foostan/mkbd/developers_guide/developrs_guide_jp.md

# 開発者向けガイド(JP)
## はじめに
これは Meishi Keyboard を開発する方向けのガイドです。
チュートリアル形式で `mkbd/pcb` のような "名刺型" のキーボードを作る過程を説明します。

## PCB 設計
### 新規プロジェクトの開始

KiCad を起動し、「ファイル > 新規 > プロジェクト」から新規プロジェクトの作成します。

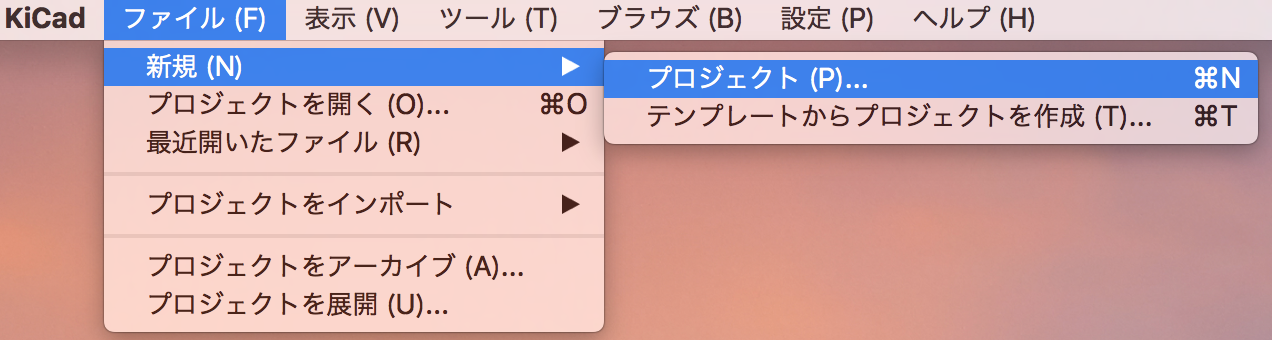
[picture p1: developers_guide/images/new_project/new_project.png]
new_project


プロジェクト名を決めて [Save] します。 

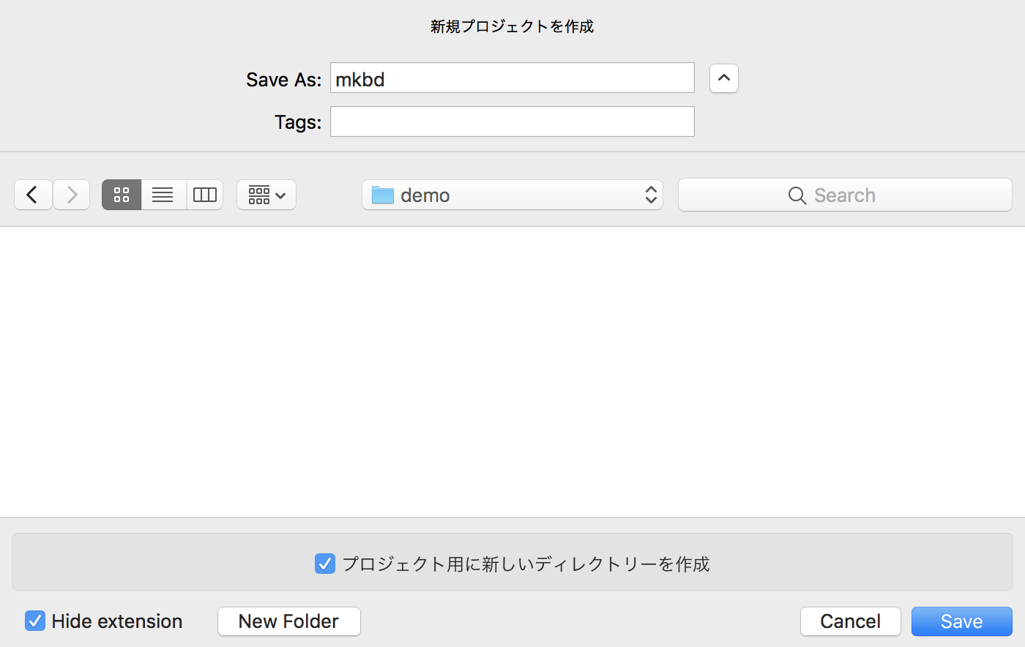
[picture p2: developers_guide/images/new_project/save_new_project.png]
save_new_project


KiCad プロジェクトのメインメニュー画面が表示されます。
各種ツールはこの画面から起動するので時間があればどのようなものがあるか確認しておきましょう。
今は時間がないので先に進みます。

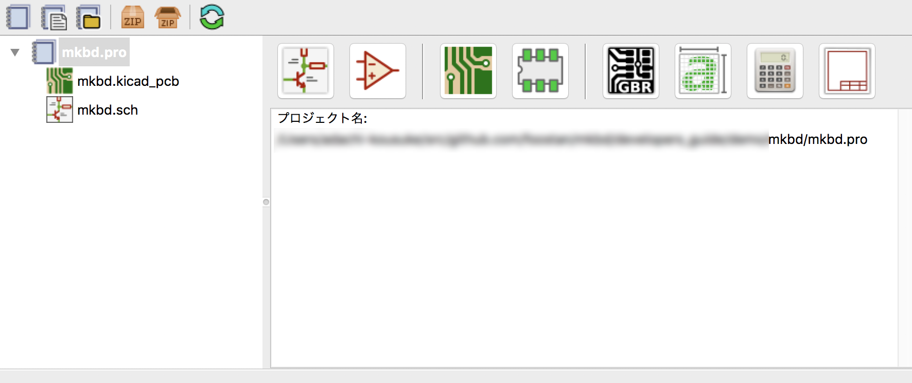
[picture p3: developers_guide/images/new_project/global_menu.png]
global_menu


### 回路設計

まずはキーボードの回路を設計していきます。
グローバルメニューから、「回路図レイアウト エディター」を開きます。

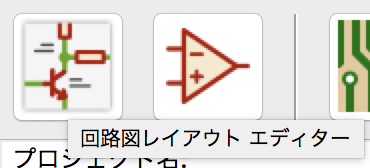
[picture p4: developers_guide/images/eeschema/open_eeschema.png]
open_eeschema


これが回路図レイアウトエディター(以降 Eeschema)の作業画面です。

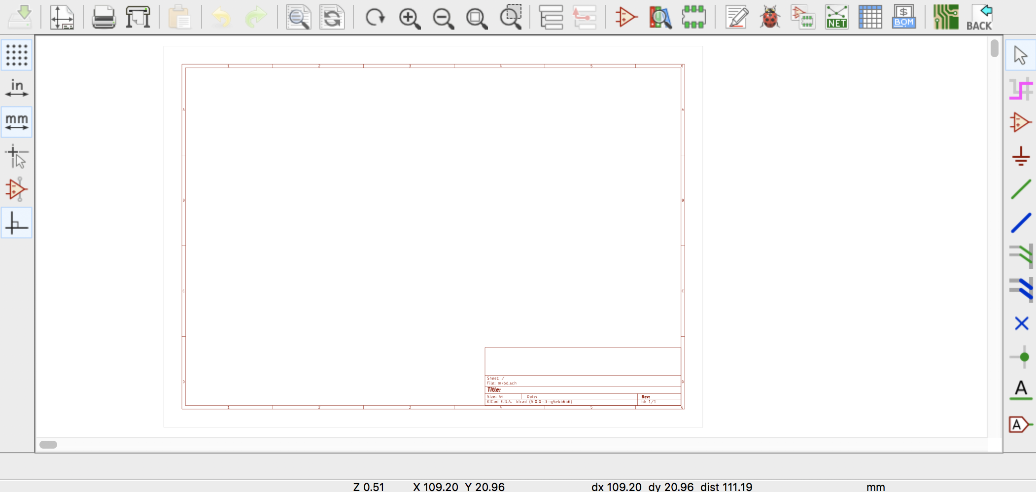
[picture p5: developers_guide/images/eeschema/start_eeschema.png]
start_eeschema


今は設計に必要な最低限な説明しかしないのでもし体系的に学びたい場合は「ヘルプ > KiCad ことはじめ」を開いて見てください。
KiCad の使い方を細かく学ぶことができるのでおすすめです。

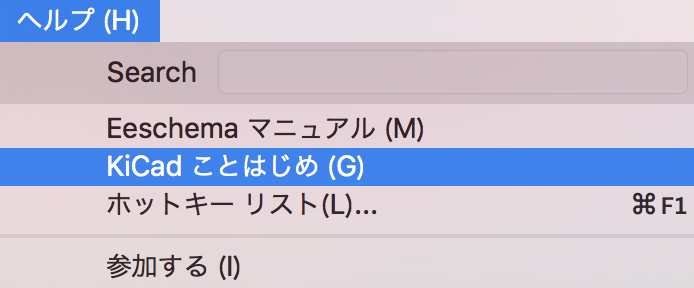
[picture p6: developers_guide/images/eeschema/kotohajime.png]
kotohajime


設計を始める前に、まずはキーボードに必要なパーツ(ライブラリ)を手に入れます。
以下のように必要なライブラリを GitHub 上から取得します。

```
$ git clone https://github.com/foostan/kbd
```

もしくは https://github.com/foostan/kbd にアクセスしてダウンロードしてください。

次に取得したライブラリを「設定 > シンボル ライブラリーを管理...」 から読み込みます。

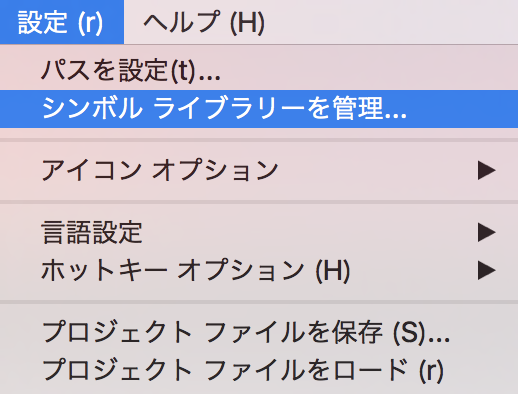
[picture p7: developers_guide/images/eeschema/manage_lib.png]
manage_lib


[ライブラリーを参照...] から `kbd/library/kbd.lib` を [Open] します。

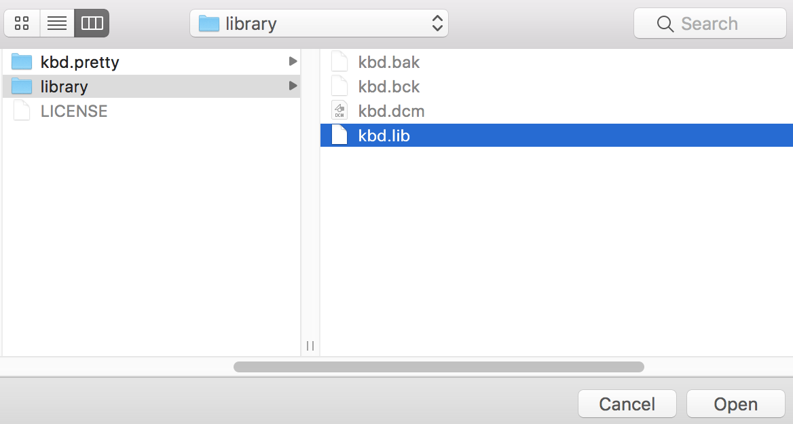
[picture p8: developers_guide/images/eeschema/open_lib.png]
open_lib


これで回路を設計する準備が整いました。
Eeschema の作業画面でショートカット `a` を押してシンボルの選択ウインドウを開きます。
検索フォームに「promicro_r」と入力して、「ProMicro_r」を選択し [OK] します。

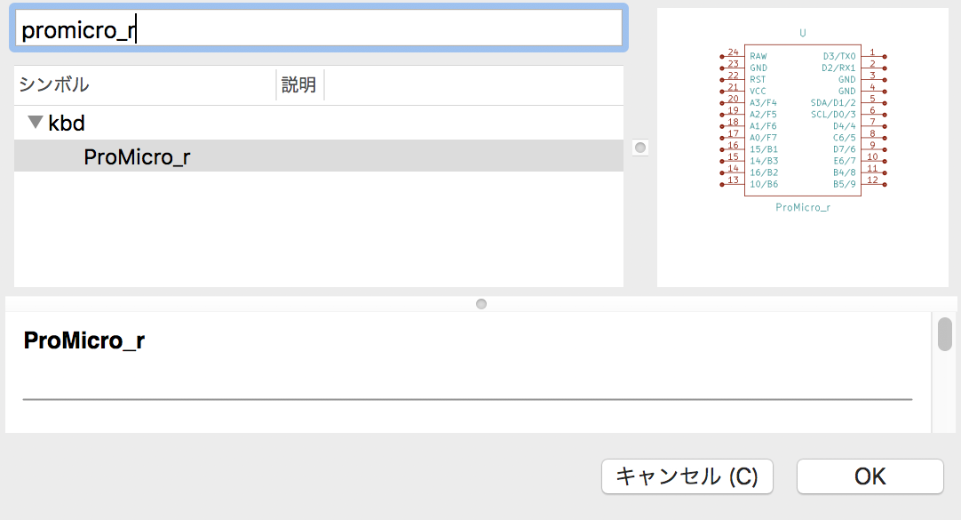
[picture p9: developers_guide/images/eeschema/add_promicro_r.png]
add_promicro_r


適当な配置します。

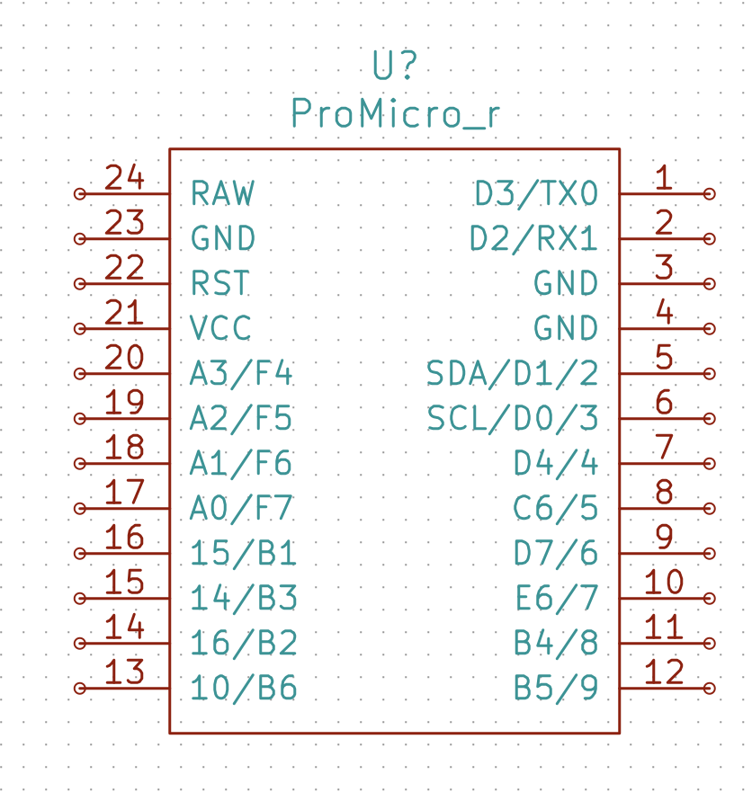
[picture p10: developers_guide/images/eeschema/set_promicro_r.png]
set_promicro_r


もし手元に実物の「ProMicro」があれば見比べてみましょう。
部品が実装されていない面の向きになっていることが確認できると思います。
回路設計においては実物と形や向きを揃える必要はありませんが、初学者にとっては実物が想像できたほうが理解が捗るので、
もし外部のライブラリーを使う場合は見てわかりやすいものを選ぶのがいいかもしれしれません。

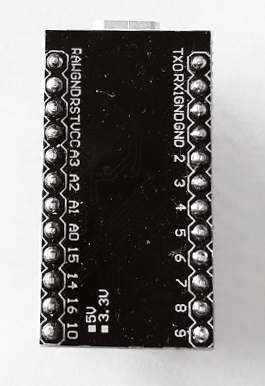
[picture p11: developers_guide/images/eeschema/promicro.png]
promicro


次にキースイッチを配置していきます。
今回は6つのキーが付いたキーボードを設計してみます。

Eeschema の作業画面でショートカット `a` を押してシンボルの選択ウインドウを開きます。

検索フォームに「sw_push」と入力して、「SW_PUSH」を選択し [OK] します。

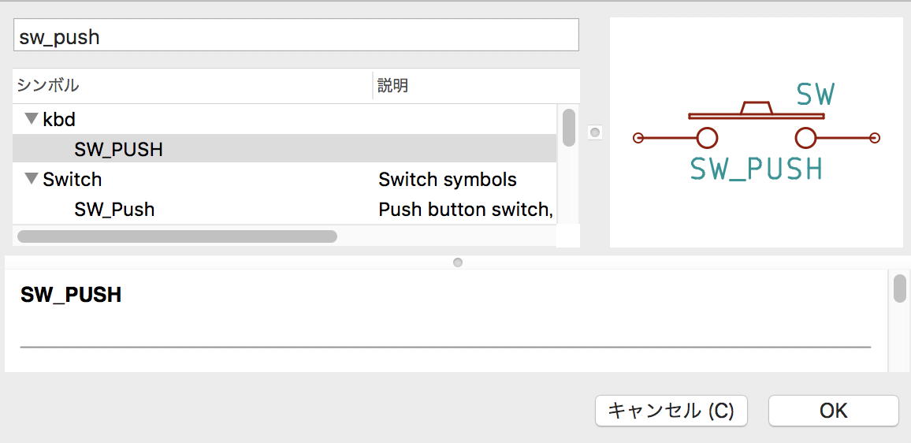
[picture p12: developers_guide/images/eeschema/add_sw_push.png]
add_sw_push


わかりやすいように整列させて並べます。
シンボルを移動させる場合は、シンボルにカーソルを合わせてショートカット `m` を押して移動させたい場所に動かします。 

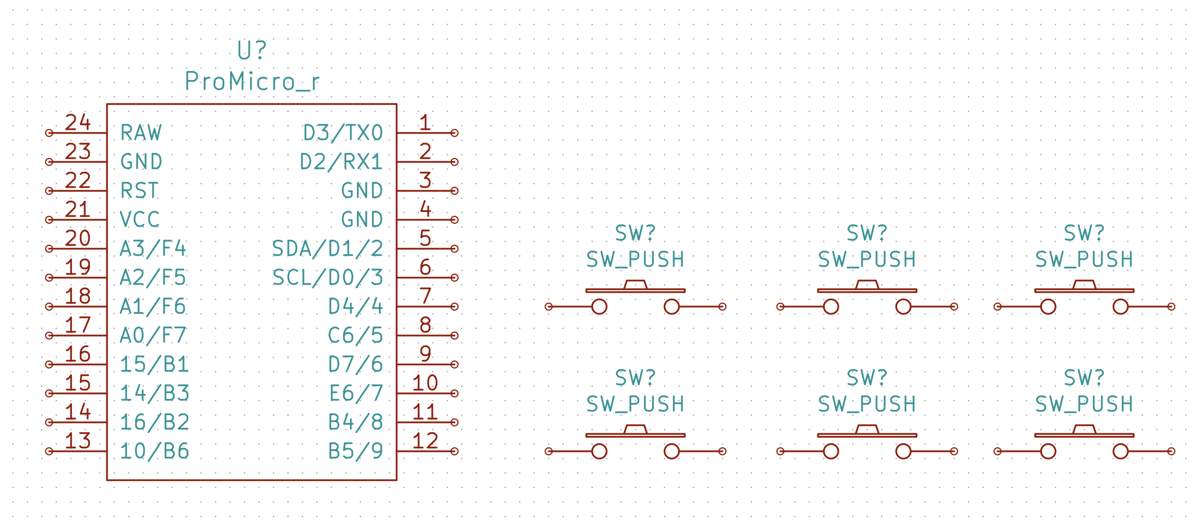
[picture p13: developers_guide/images/eeschema/set_sw_push.png]
set_sw_push


次にキースイッチをProMicroにつなげていきます。
ショートカット `w` を押して下記画像を参考にしながらつなげましょう。
もしもっとスッキリと配線させたい場合は「ラベル」を使ったやり方もあるので「KiCad ことはじめ」等でやり方を探ってみてください。

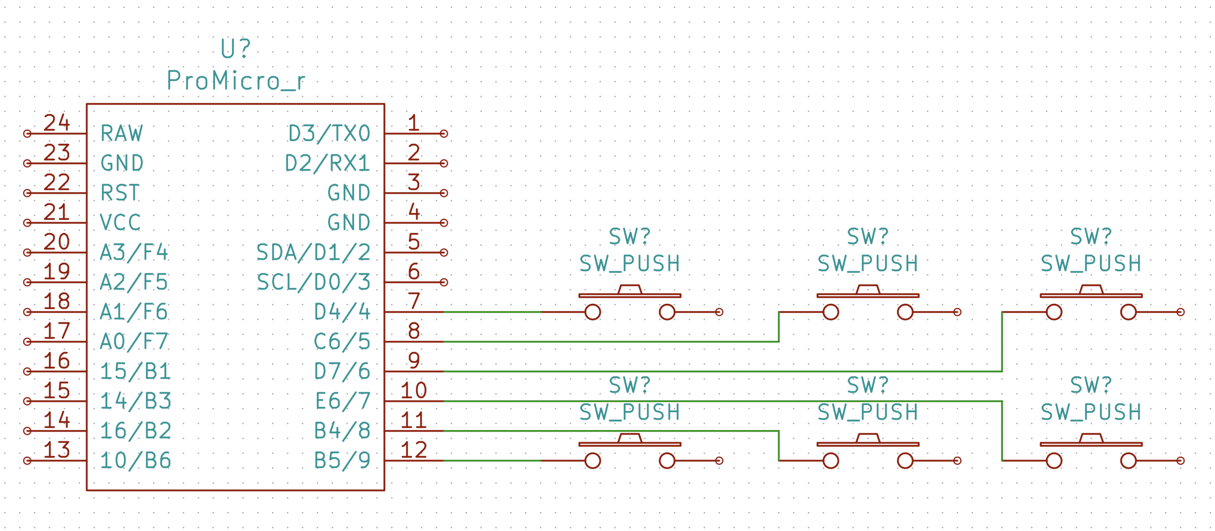
[picture p14: developers_guide/images/eeschema/wiring_sw_push.png]
wiring_sw_push


次にキースイッチのもう片方の足を GND に落とします。
Eeschema の作業画面でショートカット `a` を押してシンボルの選択ウインドウを開きます。
検索フォームに「gnd」と入力して、「GND」を選択し [OK] します。

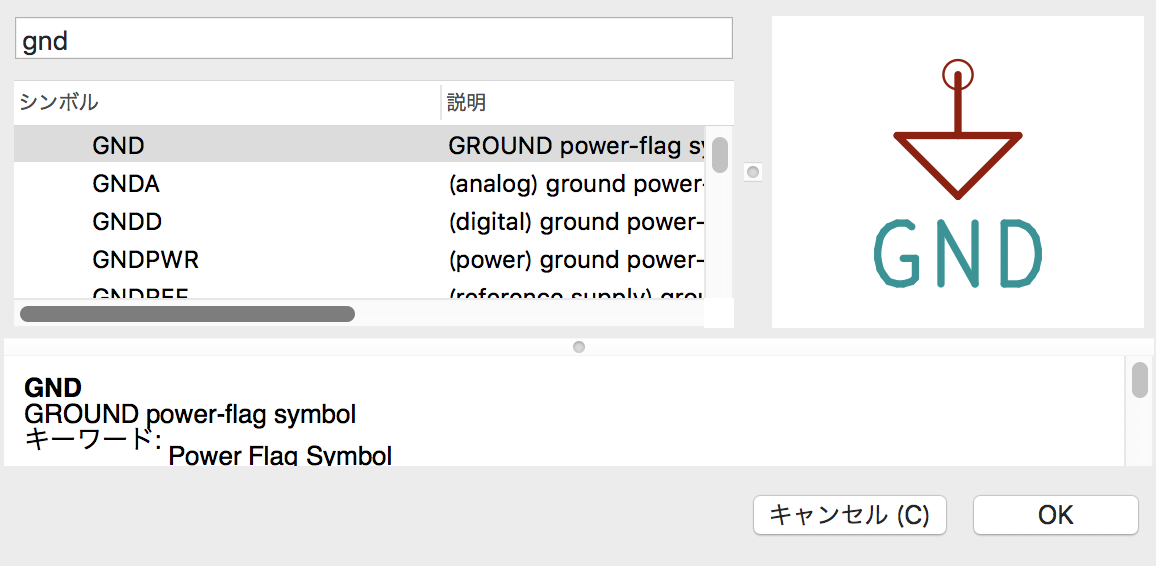
[picture p15: developers_guide/images/eeschema/add_gnd.png]
add_gnd


下記画像を参考に GND を付けていきます。
見栄えが気になった方は、ショートカット `g` や ショートカット `r` などで調整してみてください(各ショートカットの挙動は実際に確認してみてください)。

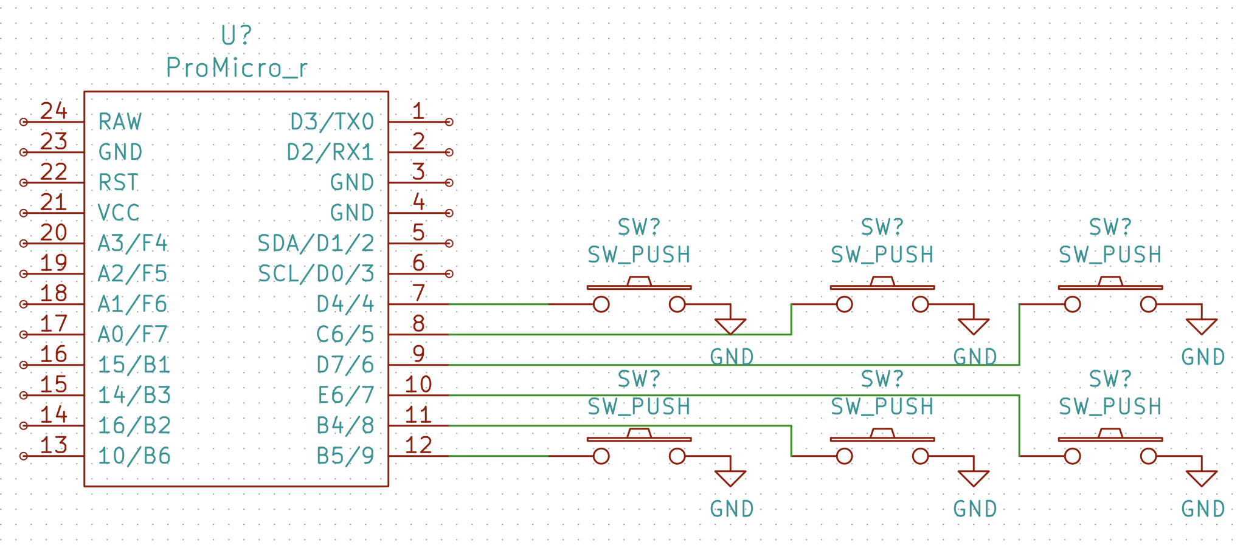
[picture p16: developers_guide/images/eeschema/set_gnd.png]
set_gnd


次にリセットスイッチを付けていきます。
Eeschema の作業画面でショートカット `a` を押してシンボルの選択ウインドウを開きます。
検索フォームに「sw_push」と入力して、「SW_Push」を選択し [OK] します。
キースイッチと同じものでも問題ありませんが、見た目が違うものの方がわかりやすいのであえて変えました。

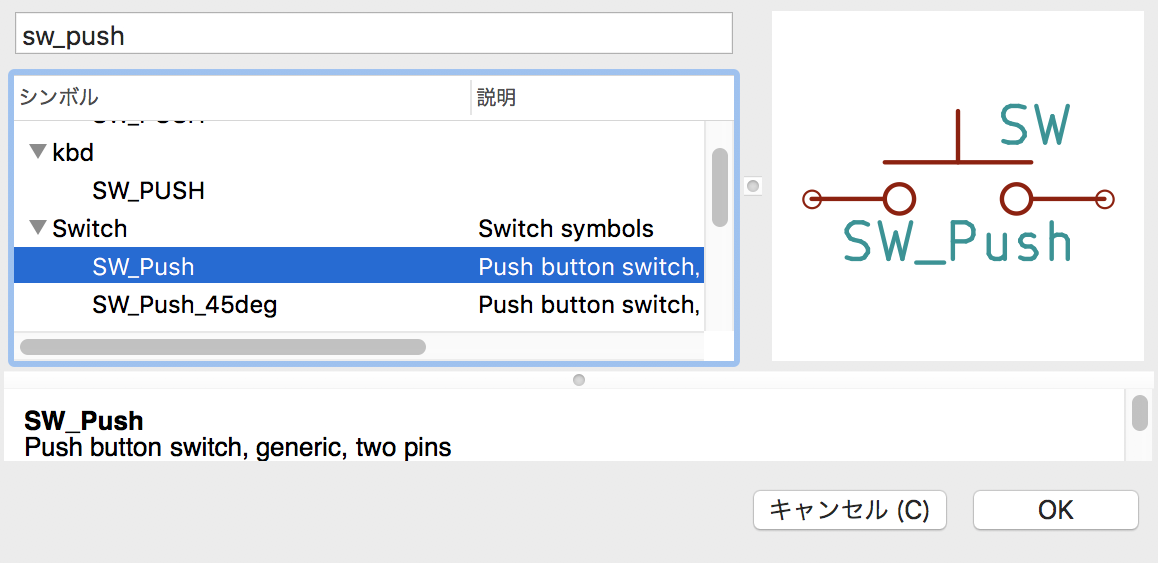
[picture p17: developers_guide/images/eeschema/add_sw_push_reset.png]
add_sw_push_reset


キースイッチと同じ方法で配線および GND を付けます。

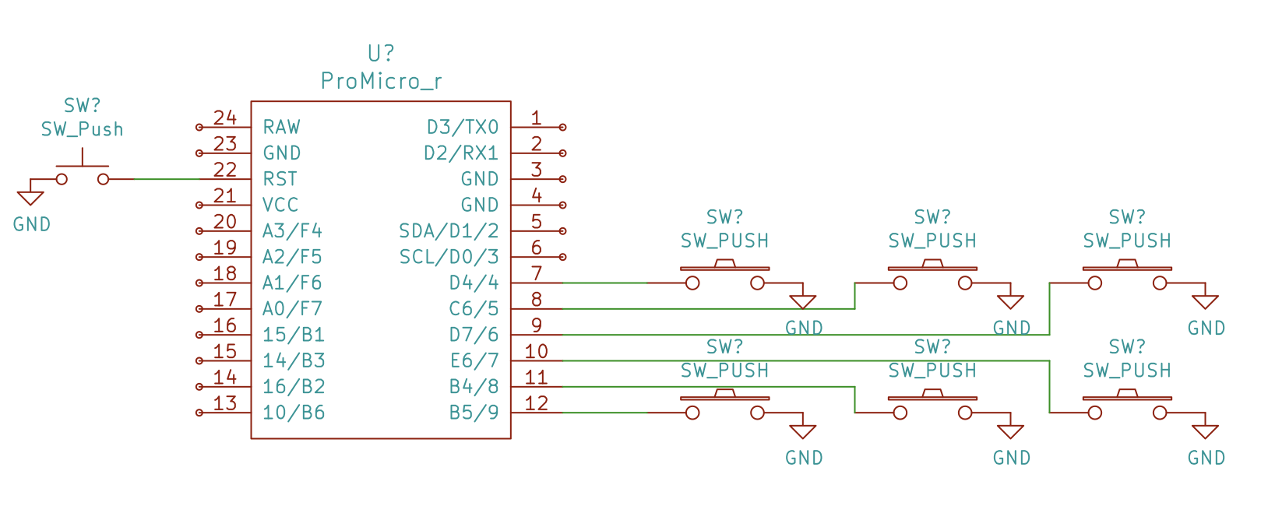
[picture p18: developers_guide/images/eeschema/set_sw_push_reset.png]
set_sw_push_reset


ProMicro_r に VCC および GND を付けます。
Eeschema の作業画面でショートカット `a` を押してシンボルの選択ウインドウを開きます。
検索フォームに「vcc」と入力して、「VCC」を選択し [OK] します。

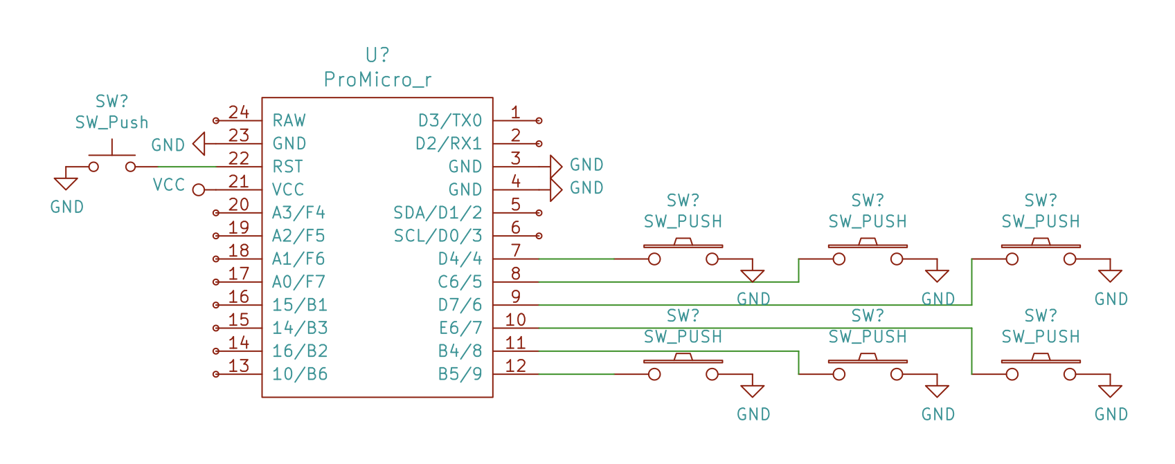
[picture p19: developers_guide/images/eeschema/set_vcc_and_gnd.png]
set_vcc_and_gnd


必要なパーツをすべて配線したので、ProMicro_r の使わないポートに「未接続フラグ」を付けていきます。

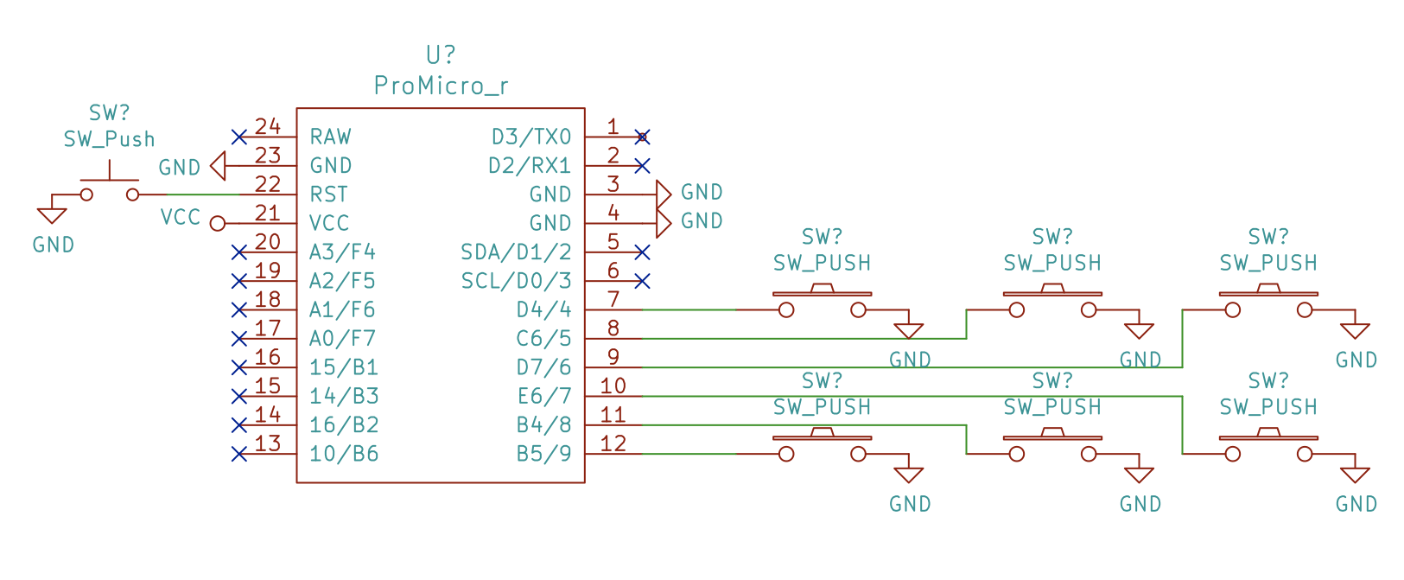
[picture p20: developers_guide/images/eeschema/set_quit_flag.png]
set_quit_flag


最後に VCC と GND に PWR_FLAG を接続します。
Eeschema の作業画面でショートカット `a` を押してシンボルの選択ウインドウを開きます。
検索フォームに「pwr_flag」と入力して、「PWR_FLAG」を選択し [OK] します。

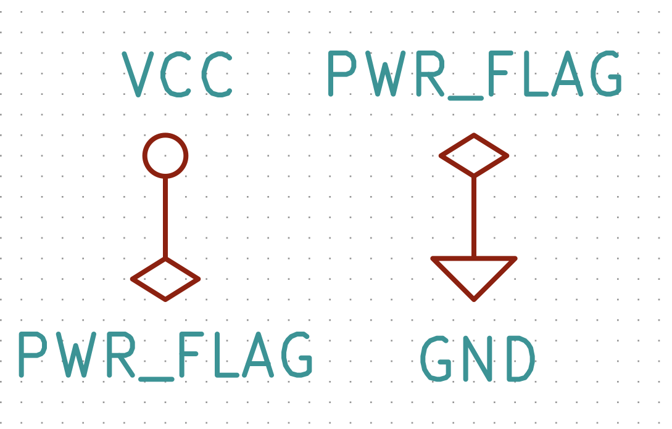
[picture p21: developers_guide/images/eeschema/set_pwr_flag.png]
set_pwr_flag


次に、設置したシンボルに番号を付けていきます。
上記メニューから「回路図シンボルをアノテーション」を選択し

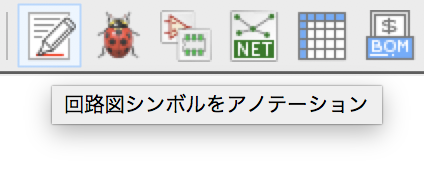
[picture p22: developers_guide/images/eeschema/annotation.png]
annotation


設定はそのままで [アノテーション] します。

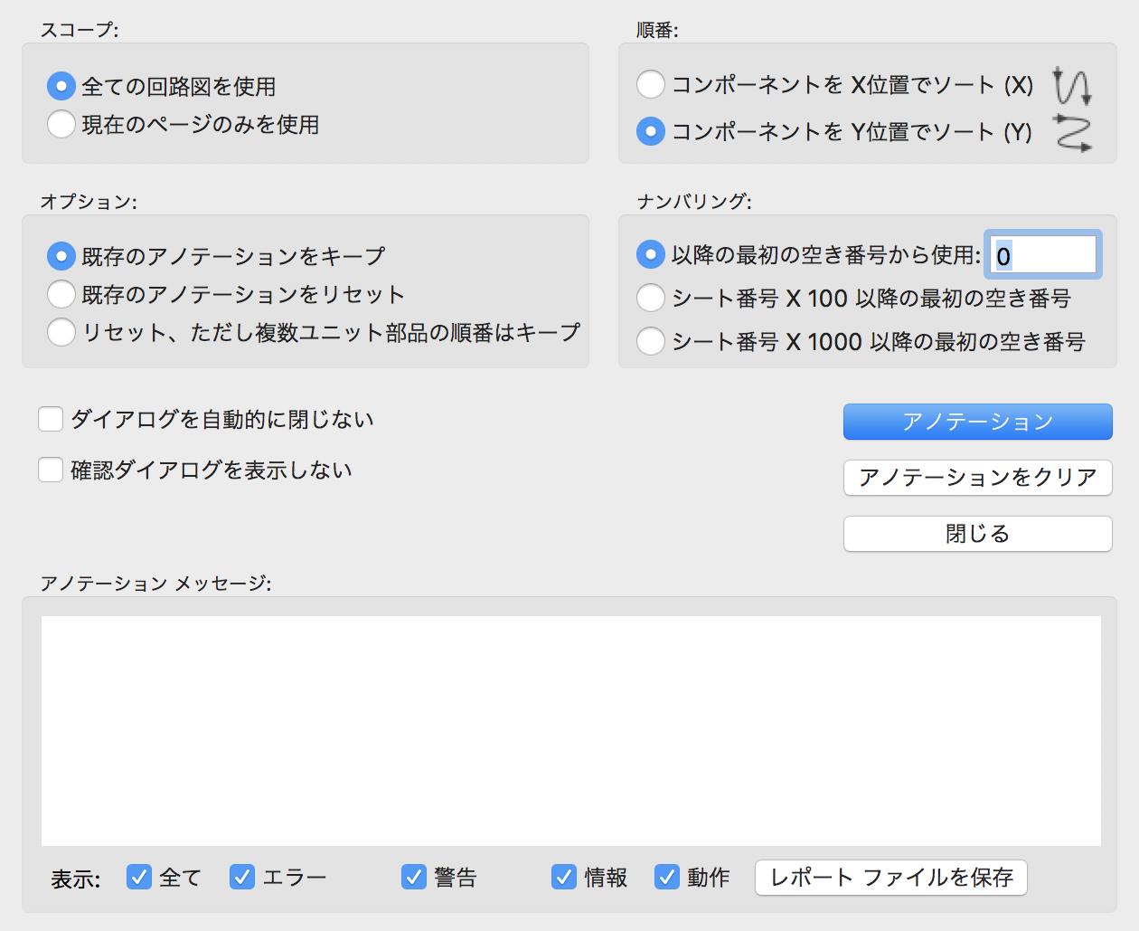
[picture p23: developers_guide/images/eeschema/set_annotation.png]
set_annotation


次に、設計した回路に不備がないかチェックします。
上記メニューから「エレクトリカル ルールのチェックを実行」を選択し

erc

[実行] します。「メッセージ」に何も警告が表示されず、「終了」とだけ表示されればOKです。

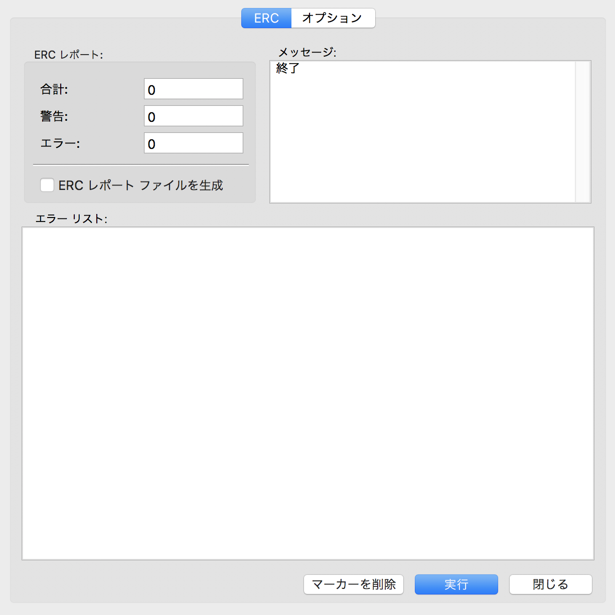
[picture p24: developers_guide/images/eeschema/run_erc.png]


次に、シンボルと実際の基板の部品(フットプリント)との紐付けを行います。
上記メニューから「回路図シンボルへPCBフットプリントを関連付ける」を選択し

run_erc

「フットプリント ライブラリー テーブルを編集」を選択し、

run_erc

[ライブラリーを参照...] から `kbd/kbd.pretty` を選択し [OK] します。

run_erc

これでキーボードに関するフットプリントが使えるようになりました。

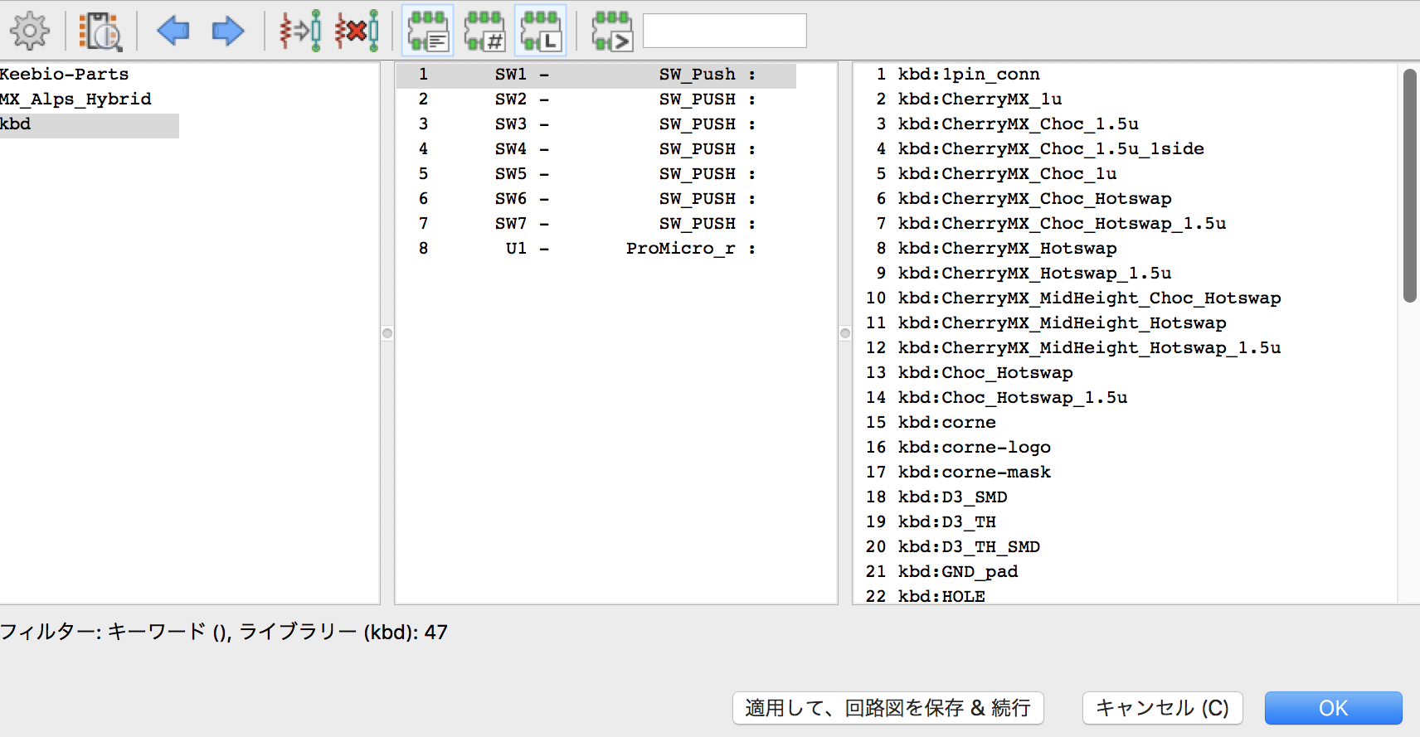
[picture p25: developers_guide/images/eeschema/start_relation.png]
start_relation


読み込んだ kbd からそれぞれ下記のように割り当てを行います。
今回の例ではSW1がリセットスイッチになっていることに注意してください。
事前にわかりやすいようにアノテーションを「RSW」などに変更しておくとわかりやすいかもしれません
(アノテーションの変更はシンボルにカーソルを合わせて、ショートカット `e` でできます)。

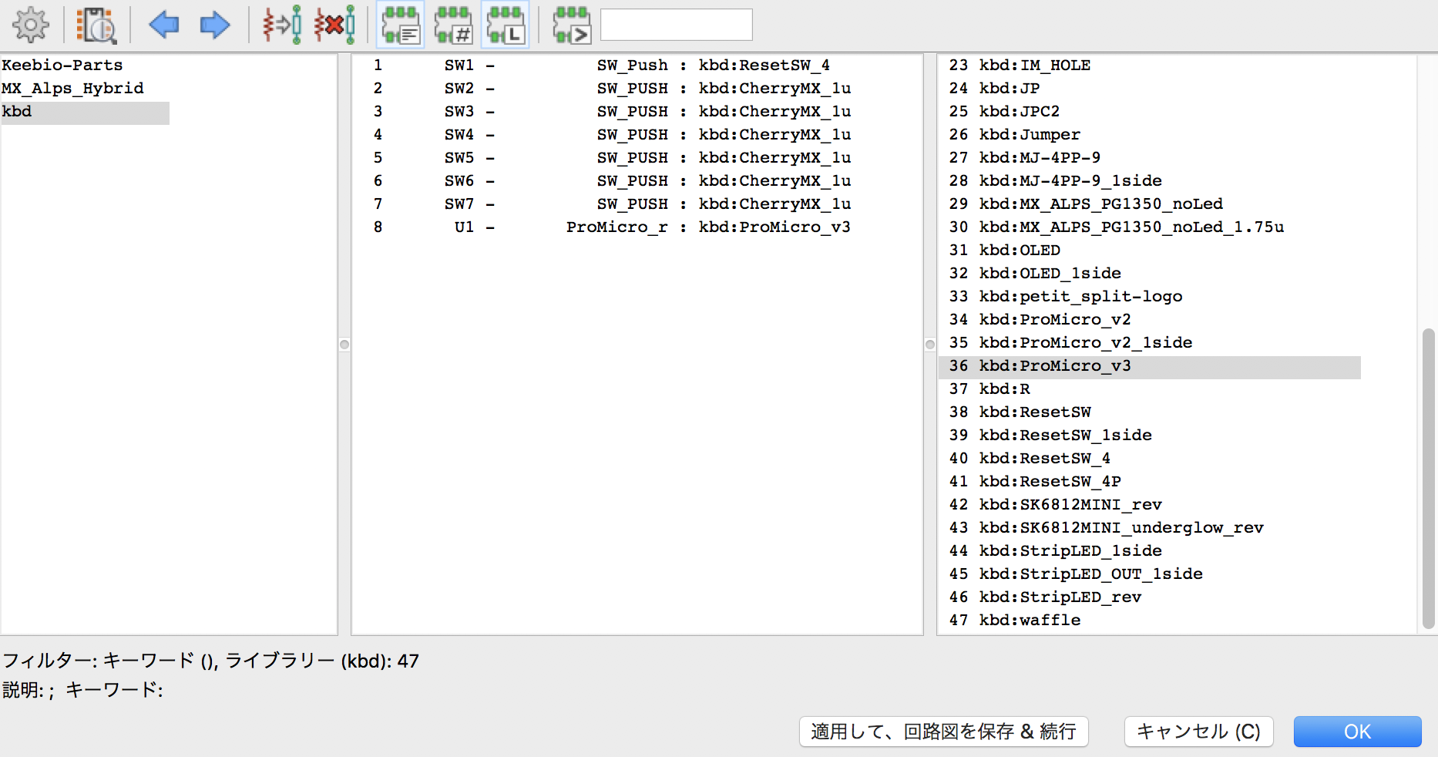
[picture p26: developers_guide/images/eeschema/finish_relate.png]
finish_relate


またフットプリントを確認したい場合は、右側の枠からフットプリントを選択して「選択したフットプリントを見る」から見れます。

show_footprint
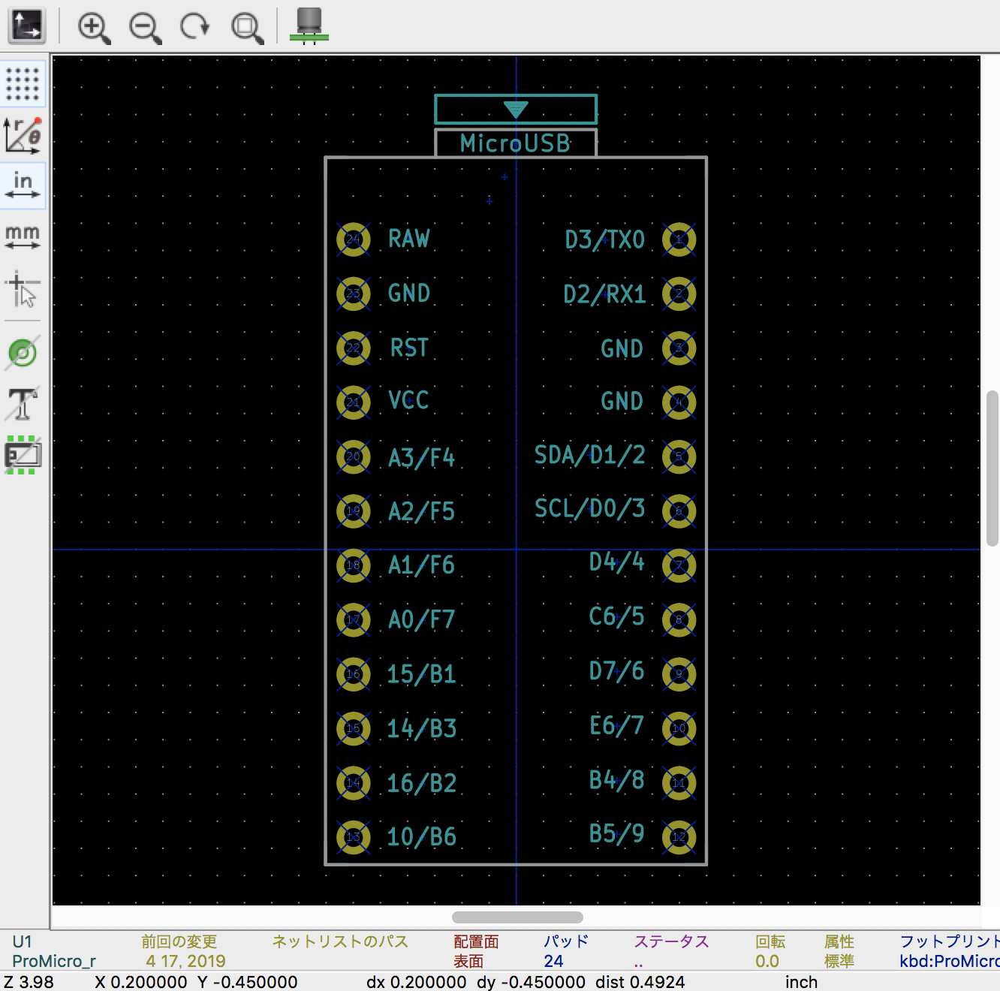
[picture p27: developers_guide/images/eeschema/show_selected_footprint.png]
show_selected_footprint


最後に上記メニューから「ネットリストを生成」を選択して、
output_netlist

[ネットリストを生成] からネットリストと呼ばれる回路情報をファイルとして出力します。
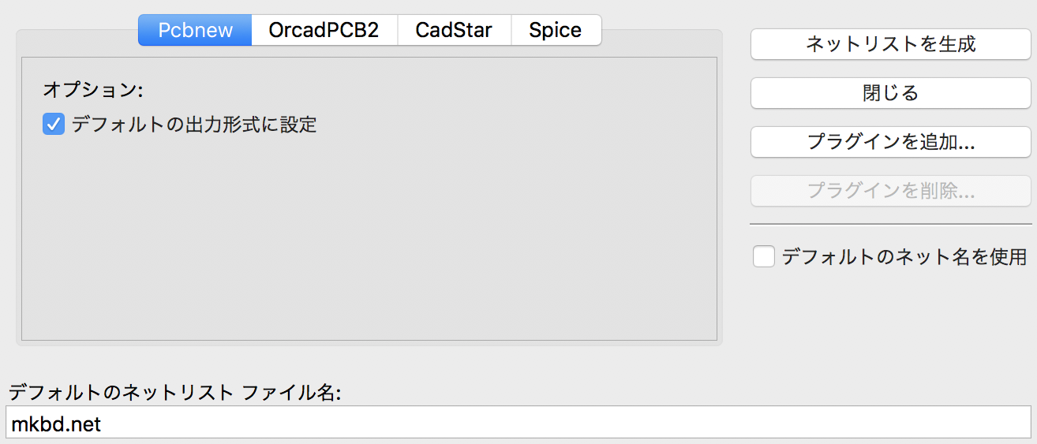
[picture p28: developers_guide/images/eeschema/output_netlist_to_file.png]
output_netlist_to_file


回路設計は以上で完了です。

### PCBの作成

グローバルメニューまで戻り、「基板レイアウト エディター」を選択します。
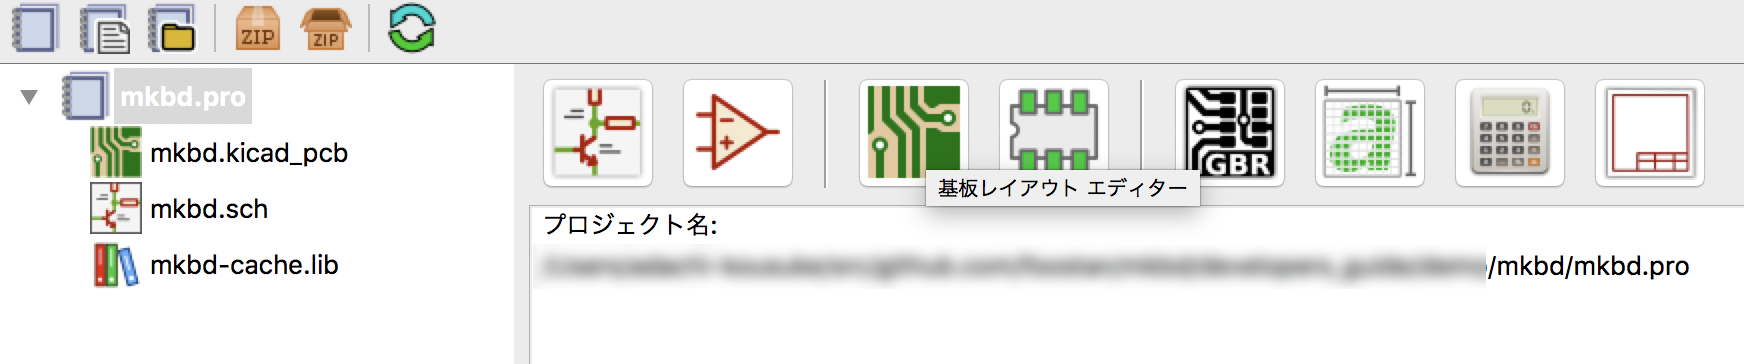
[picture p29: developers_guide/images/pcbnew/open_pcbnew.png]
open_pcbnew


これが基板レイアウト エディター(以降 Pcbnew) の作業画面です。
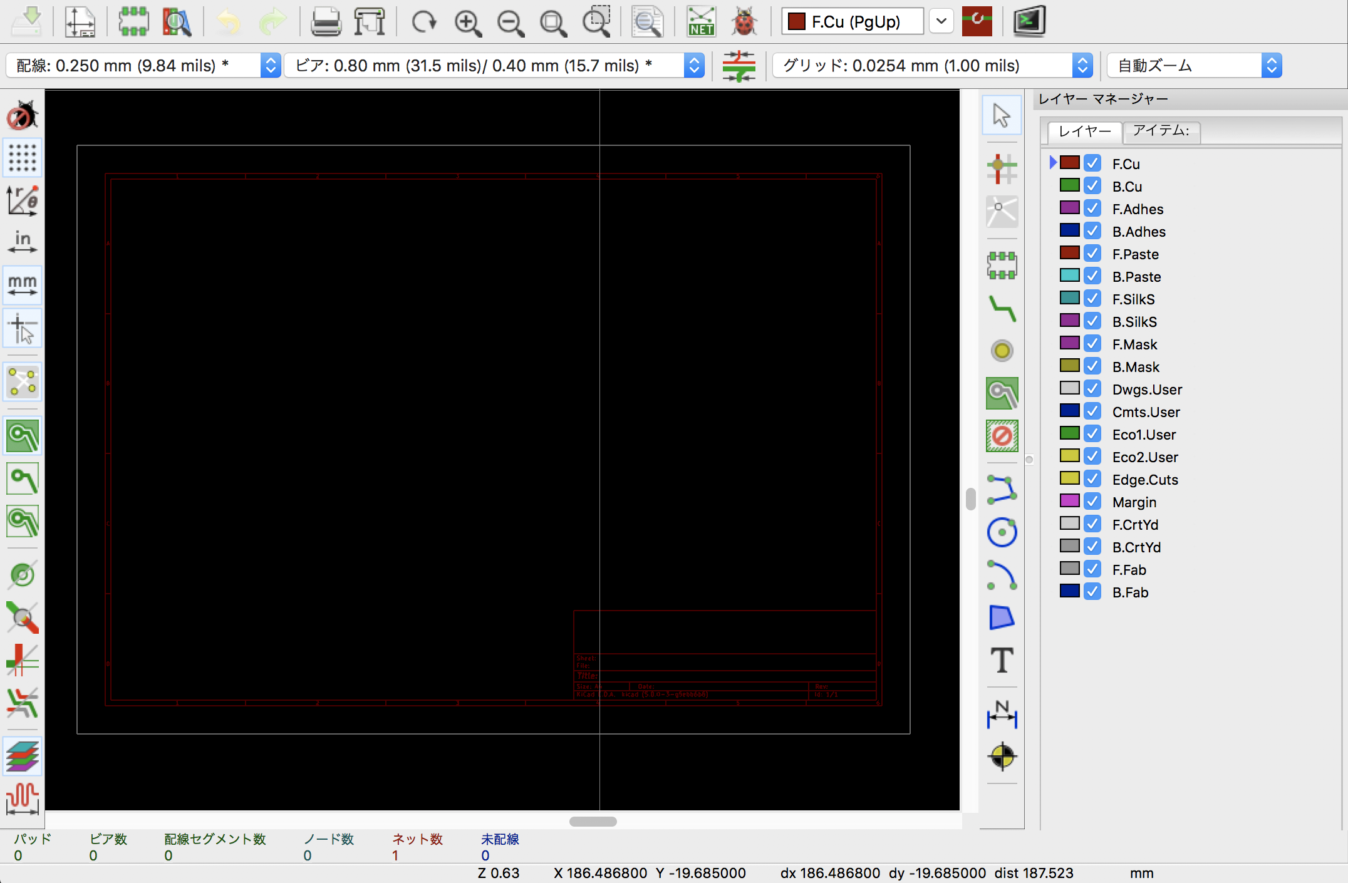
[picture p30: developers_guide/images/pcbnew/pcbnew.png]
pcbnew


まずはここに先程作成した回路データを読み込みます。
上記メニューの「ネットリストの読み込み」を選択し
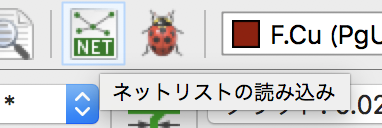
[picture p31: developers_guide/images/pcbnew/open_netlist.png]
open_netlist


[現在のネットリストを読み込む]を選択します。
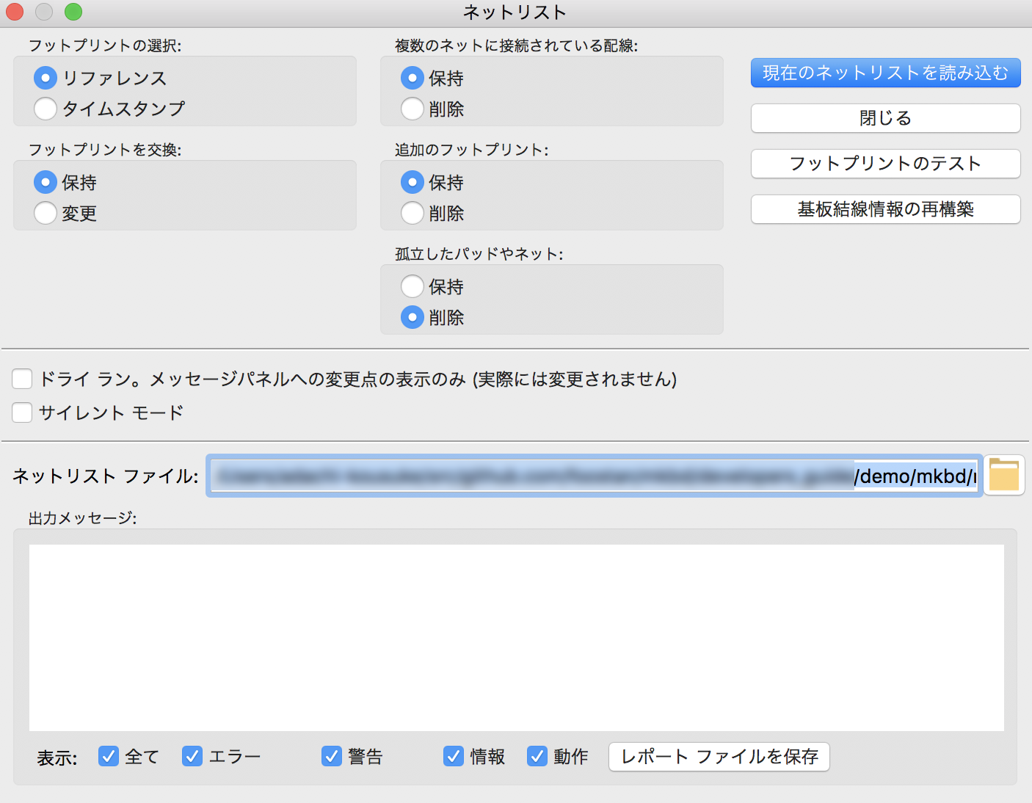
[picture p32: developers_guide/images/pcbnew/load_netlist.png]
load_netlist


下記のように各フットプリントが読み込まれていればOKです。
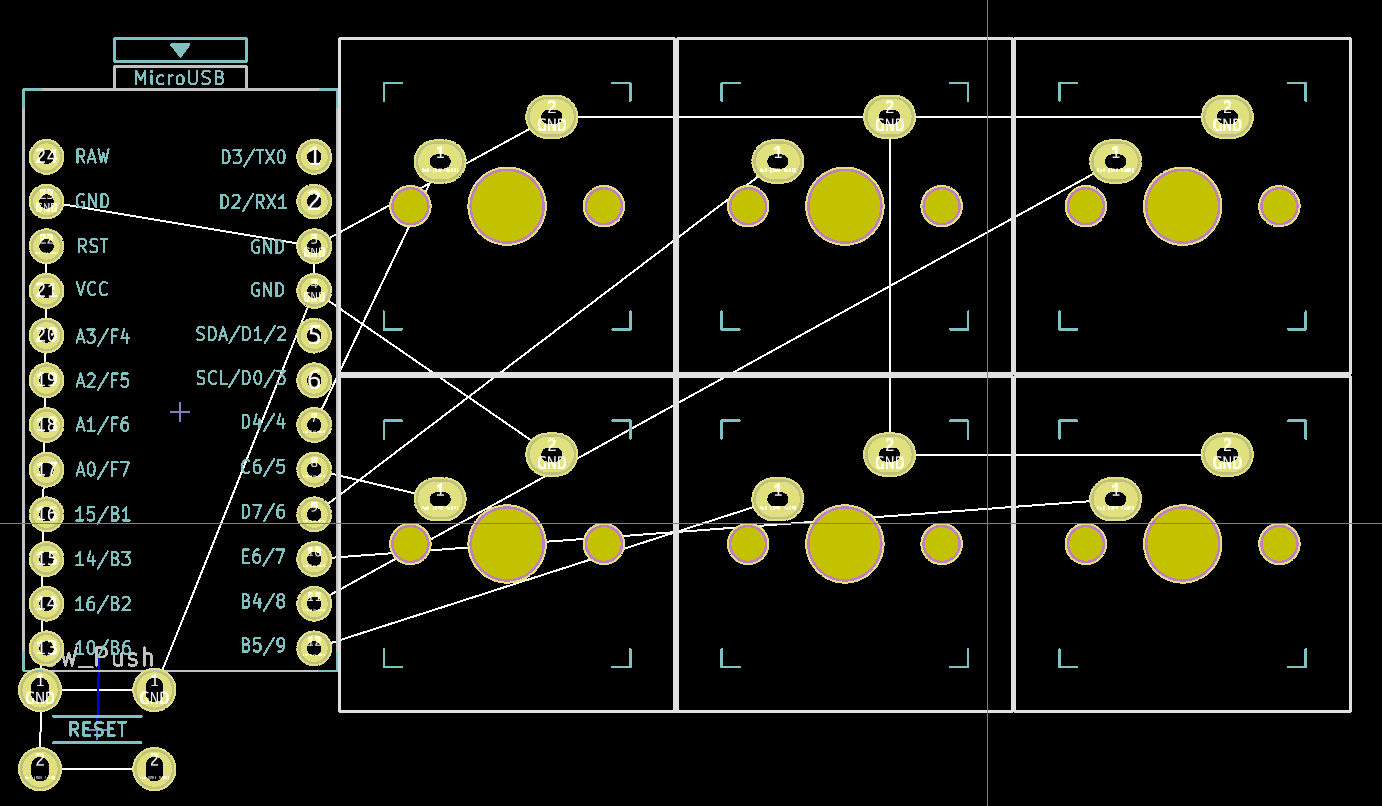
[picture p33: developers_guide/images/pcbnew/loaded_netlist.png]
loaded_netlist


まずは名刺の枠を作っていきます。
ちなみに名刺のサイズは 91mm x 55mm です。

上記メニューから作業するレイヤーを 「Edge.Cuts」 に変更し、
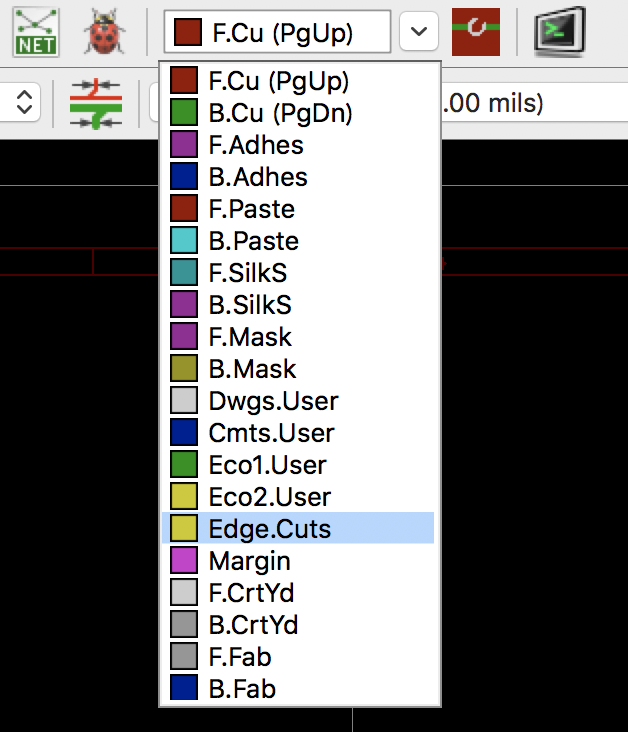
[picture p34: developers_guide/images/pcbnew/select_edge_cut.png]
select_edge_cut


右メニューから「図形ラインを追加」を選択します。
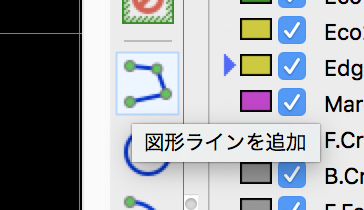
[picture p35: developers_guide/images/pcbnew/add_line.png]
add_line


まずは大まかに四角形を作ります。
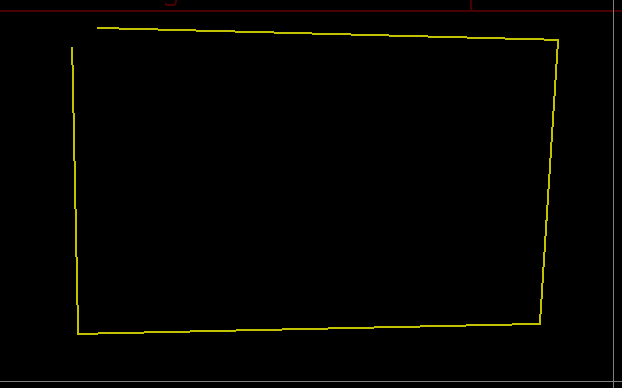
[picture p36: developers_guide/images/pcbnew/draw_lines.png]
draw_lines


次に線にカーソルを合わせてショートカット `e` で「配線セグメントのプロパティ」を表示します。
この始点 X、始点 Y、終点 X、終点 Yで線の位置を決定していきます。``
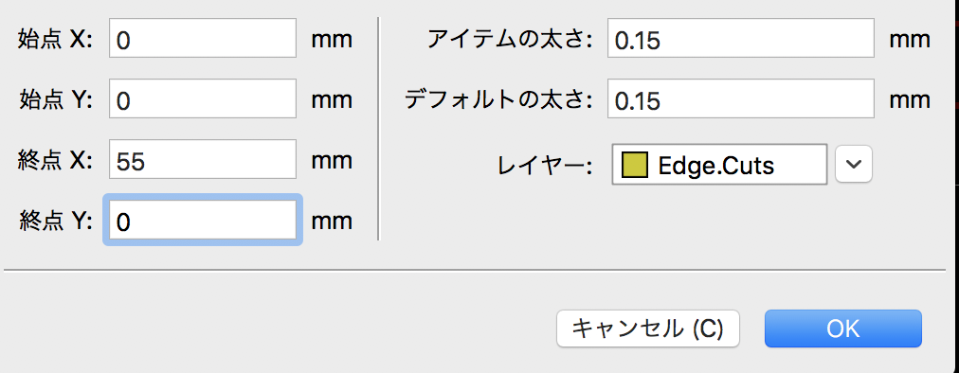
[picture p37: developers_guide/images/pcbnew/edit_xy.png]
edit_xy


4本線があると思うのでそれぞれ、

1本目
- 始点 X: 0
- 始点 Y: 0
- 終点 X: 91
- 終点 Y: 0

2本目
- 始点 X: 91
- 始点 Y: 0
- 終点 X: 91
- 終点 Y: 55

3本目
- 始点 X: 91
- 始点 Y: 55
- 終点 X: 0
- 終点 Y: 55

4本目
- 始点 X: 0
- 始点 Y: 55
- 終点 X: 0
- 終点 Y: 0

を指定します。

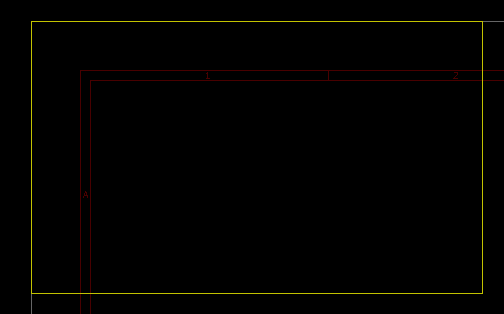
[picture p38: developers_guide/images/pcbnew/edge_cut.png]
edge_cut


これだと角が尖っていて痛いので丸めます。

まずは作業がしやすいように、グリッドの設定をします。
0.1mm でいいと思います。
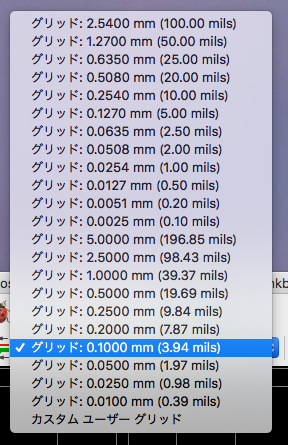
[picture p39: developers_guide/images/pcbnew/select_0.1mm.png]
select_0.1mm


「次に円弧を追加」を選択して角を丸めます。

add_enko

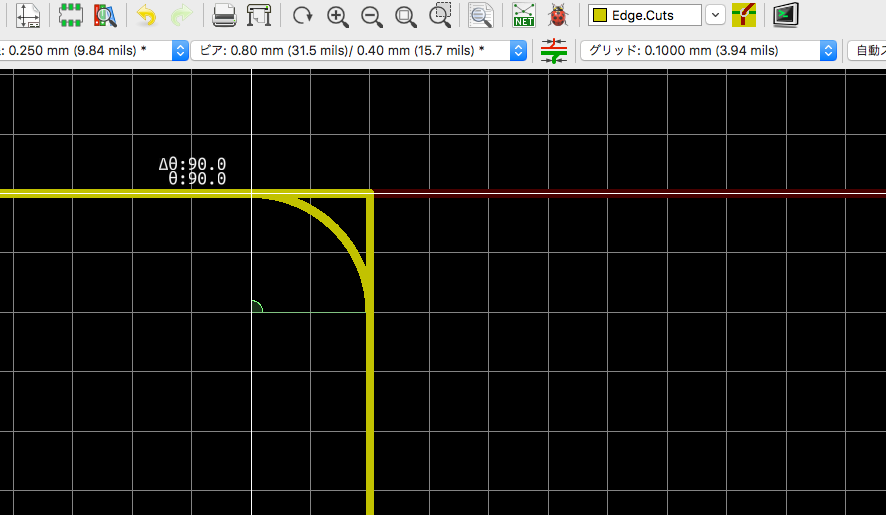
[picture p40: developers_guide/images/pcbnew/set_enko.png]
set_enko


次にキースイッチのフットプリントを並べていきます。
キースイッチのピッチはCherryMX系の場合は一般的には19.05mmです。

まずはカスタムのグリッド設定を行うため、「表示  > グリッド設定」を選び、サイズ X およびサイズ Y を 19.05 にします。

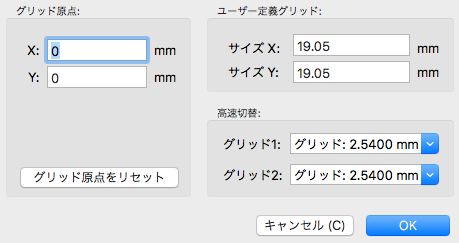
[picture p41: developers_guide/images/pcbnew/grid_setting.png]
grid_setting


その後上記メニューのグリッド設定を「カスタム ユーザー グリッド」にすると、19.05mm 単位のグリッドが表示されます。
あとはこのグリッドに沿ってキースイッチを並べます。
なお、フットプリントの移動はフットプリントにカーソルを合わせて、ショートカットキー `m` でできます。

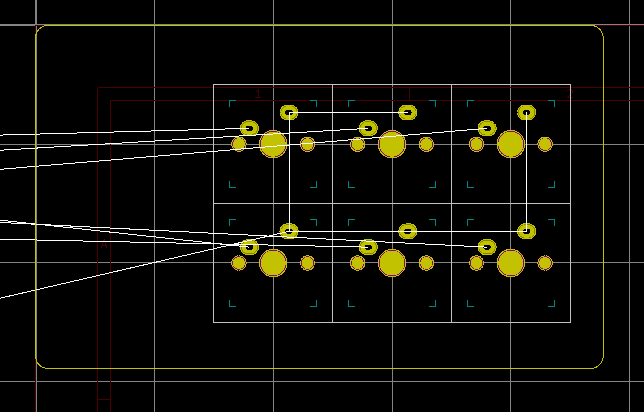
[picture p42: developers_guide/images/pcbnew/set_key_sw.png]
set_key_sw


次にグリッド設定を0.1mm等に戻して、下記のようにProMicroとリセットスイッチを配置します。
基本的には好みで構わないのですが、ProMicroについてはUSB側が外形に重なるように配置します
(もっと内側に設置してしまうと、USBケーブルが干渉してさせなくなります)。

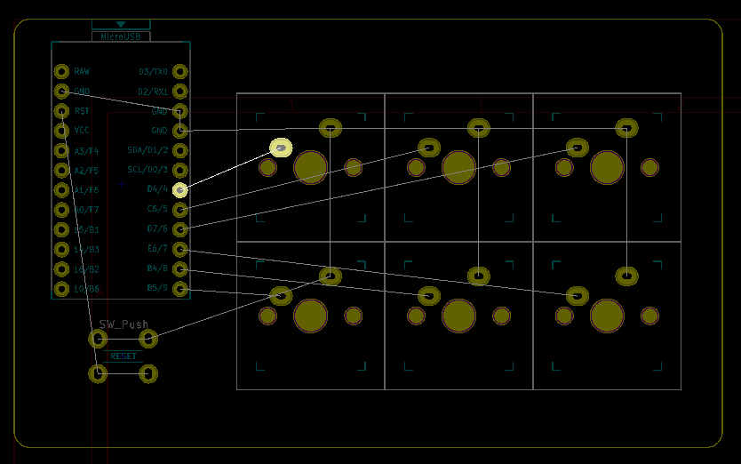
[picture p43: developers_guide/images/pcbnew/set_promicro_and_reset.png]
set_promicro_and_reset


次に配線をしていきます。ラッツネスト(ホールやパッドをつなぐ細長い白い線)が、配線すべき箇所を表しています。
きれいに配線するにはこのラッツネストを参考にして、どう配線していくか計画をたてるとうまくいくと思います。

配線はまず、上記メニューから 「F.Cu」レイヤに切り替えて 
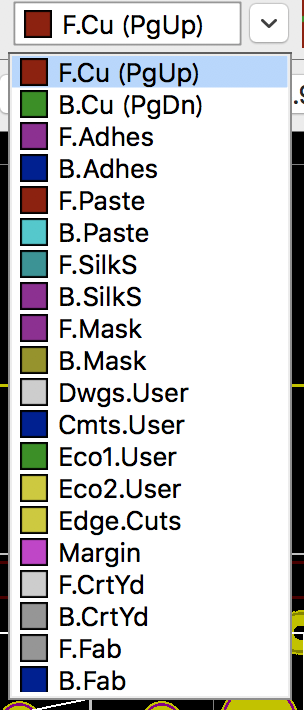
[picture p44: developers_guide/images/pcbnew/select_fcu.png]
select_fcu


右メニューの「配線」から行います。

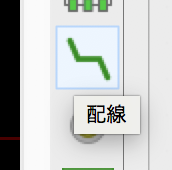
[picture p45: developers_guide/images/pcbnew/line.png]
line


なお GND は別途処理をするのでそれ以外の配線を行います。
配線にカーソルを合わせて、ショートカットキー `d` や、
フットプリントにカーソルを合わせて、ショートカットキー `r` などの操作を行い、
なるべくシンプルな配線になるように心がけます。

配線の例はこちらです。

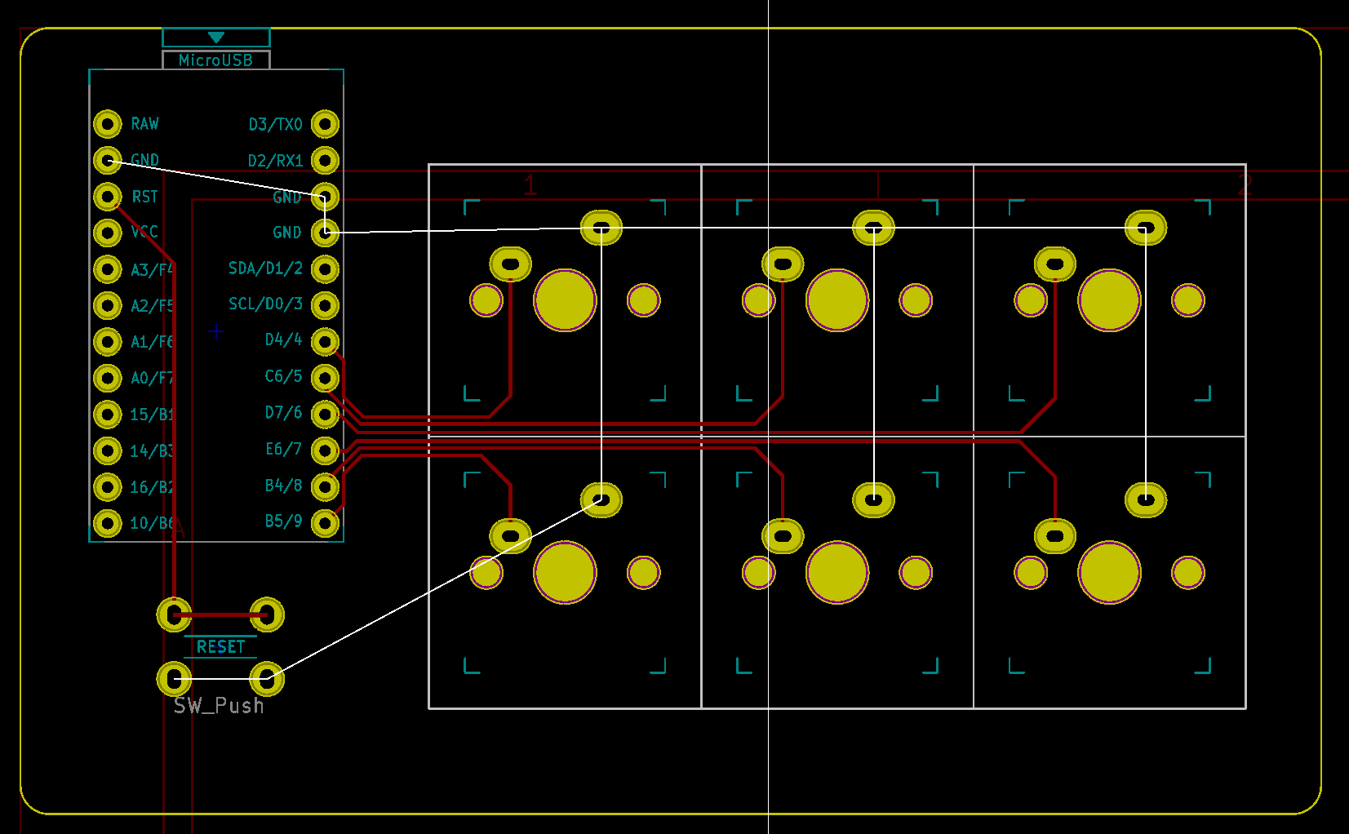
[picture p46: developers_guide/images/pcbnew/finished_line.png]
finished_line


次に GND の処理をします。右メニューから「塗りつぶしゾーンを追加」を選択し、外形を覆うように配置します。

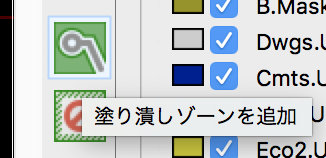
[picture p47: developers_guide/images/pcbnew/beta.png]
beta


設定は以下のとおりです。レイヤーを 「F.Cu」にし、ネットを「GND」にしてあとはデフォルトのままです。

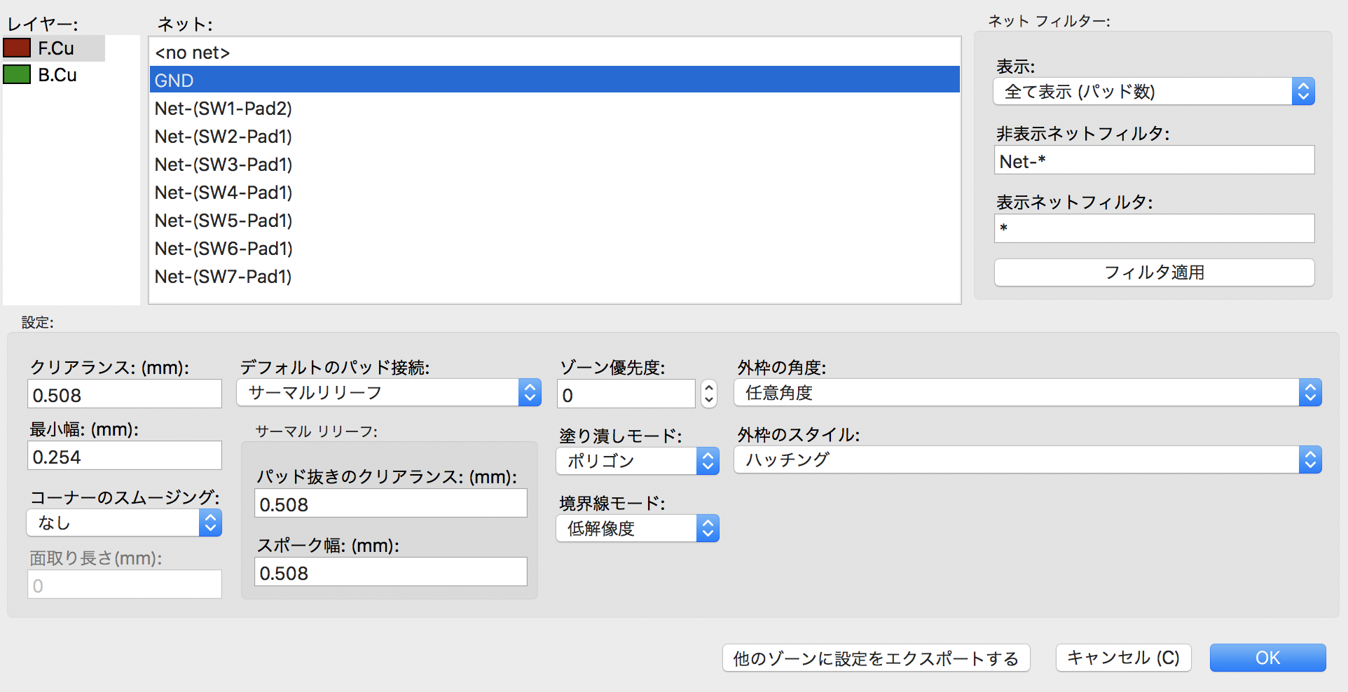
[picture p48: developers_guide/images/pcbnew/set_zone.png]
set_zone


正しくゾーンが設置できると以下のようになります。
未接続だった GND が全てつながっているはずです。

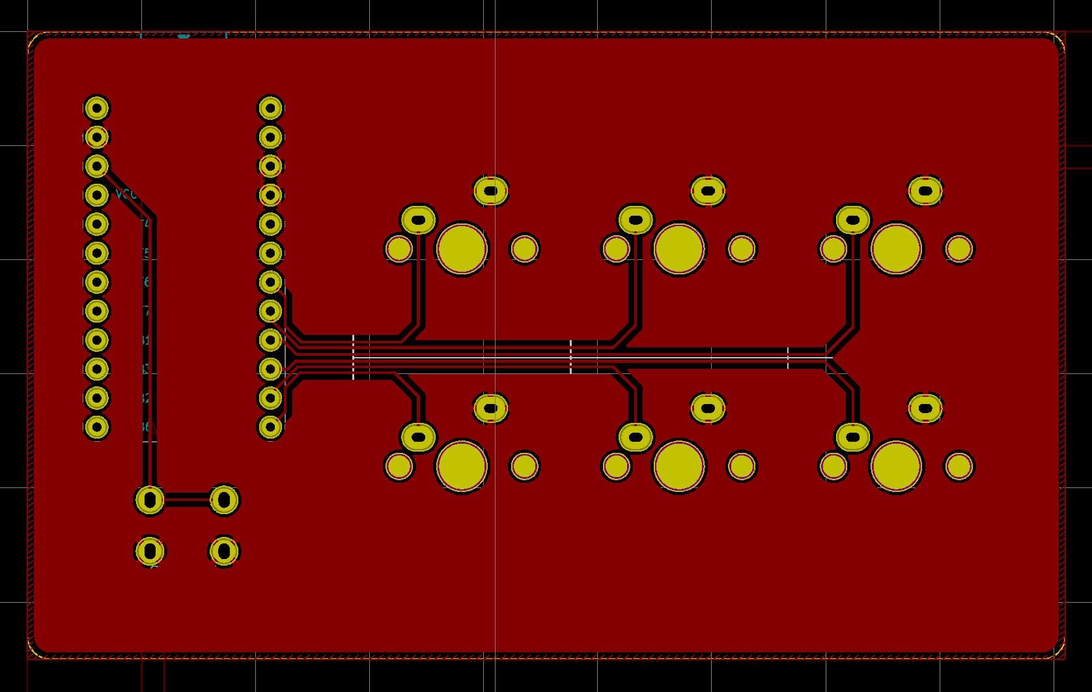
[picture p49: developers_guide/images/pcbnew/finished_zone.png]
finished_zone


今回の場合ゾーンは F.Cu レイヤだけで動作的には問題ありませんが、
裏表の仕上がりに差が出てしまうので B.Cu レイヤにもゾーンを配置します。

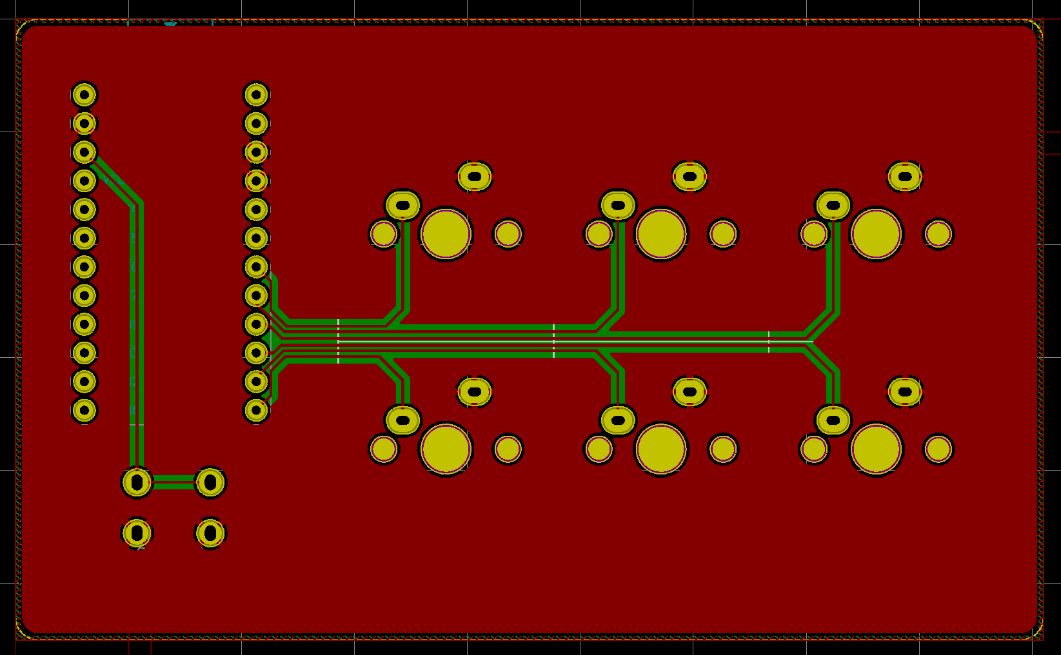
[picture p50: developers_guide/images/pcbnew/finished_line_and_zone.png]
finished_line_and_zone


次に「名刺」として機能するようにシルクで名前を入れていきます。
好みのドローソフトやペイントソフトを使用して名刺画像を作成します。

今回は PhotoShop を使います。
幅 91mm x 高さ 55mm で 300 ppi で新規作成します。 

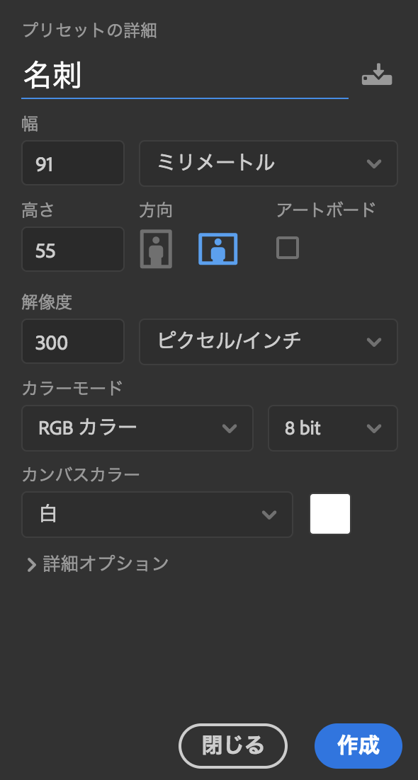
[picture p51: developers_guide/images/pcbnew/new_meishi.png]
new_meishi


今回作成したものはこちらです。
背景を黒にして2色で作成します。

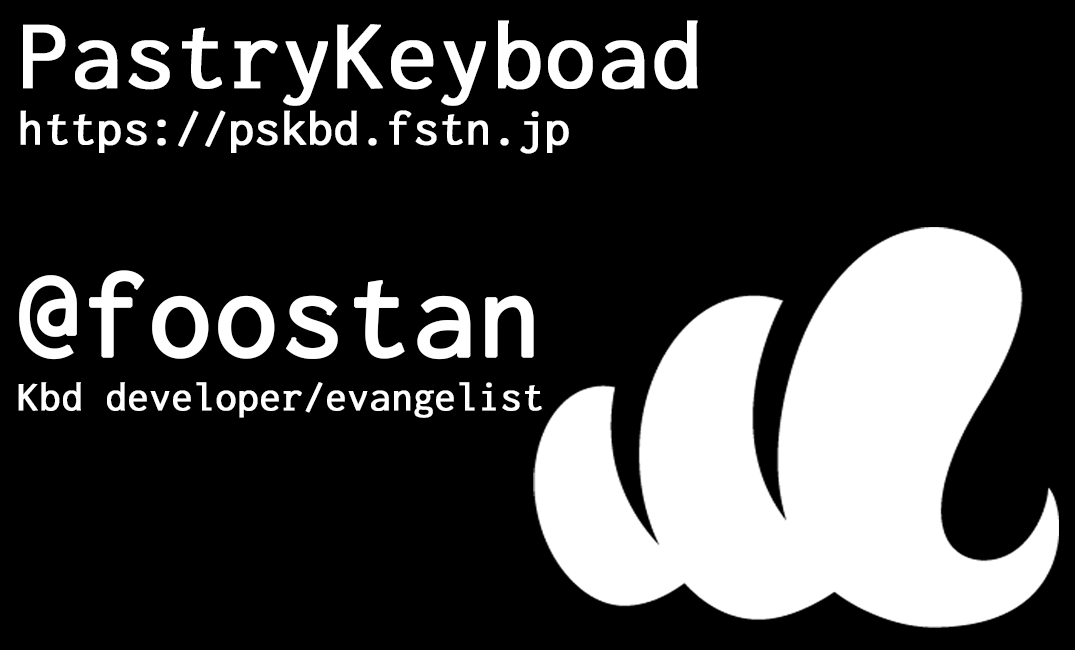
[picture p52: developers_guide/images/pcbnew/mkbd.png]
mkbd


一旦グローバルメニューにもどり「インポート ビットマップ」を選択します。

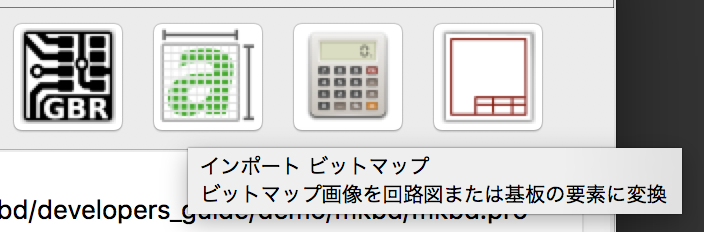
[picture p53: developers_guide/images/pcbnew/import_bitmap.png]
import_bitmap


ここで先ほど作成した画像を読み込みます。
設定はデフォルトのままで大丈夫だと思いますが、一応サイズと解像度は確認しておきましょう。

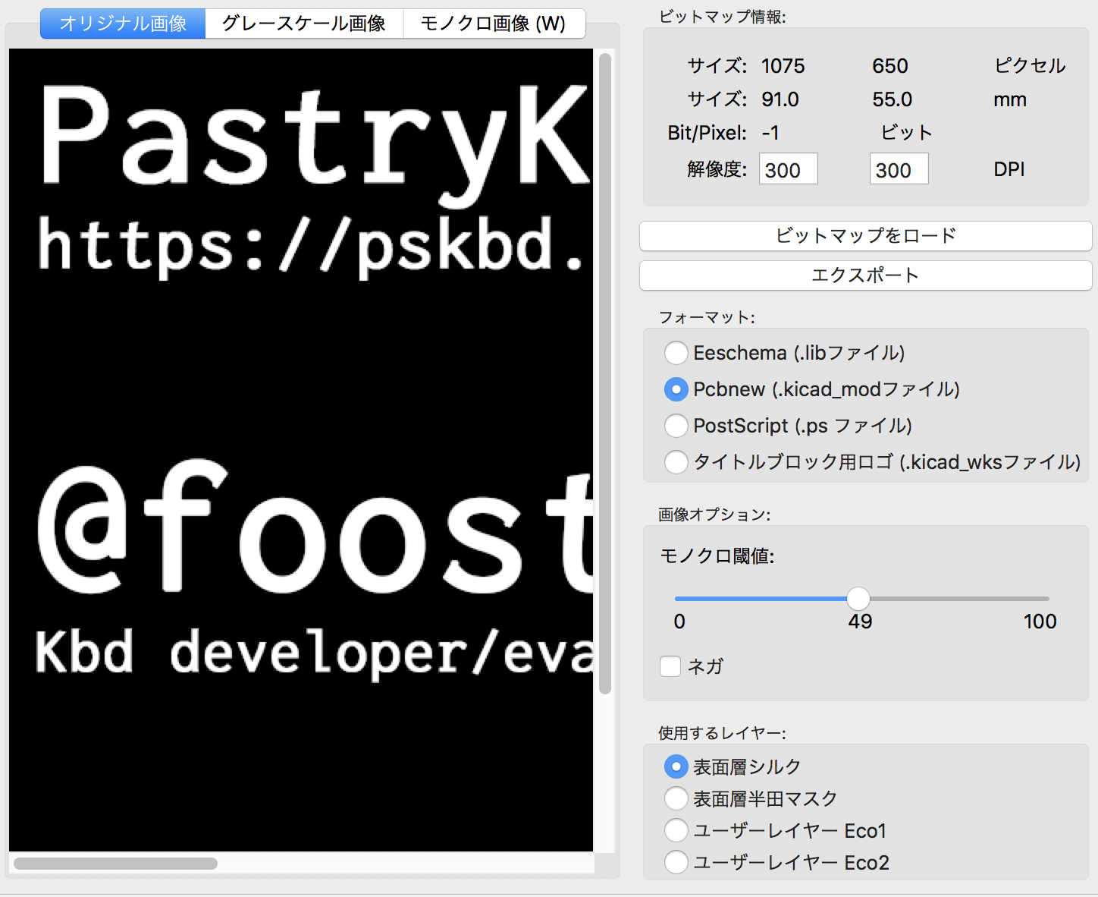
[picture p54: developers_guide/images/pcbnew/import_meishi.png]
import_meishi


[エクスポート] で Pcbnew で読み込めるシルクデータとして保存します。
なお注意としてはかならず「*.pretty」というフォルダを新規に作成してその中に保存してください。

今回の場合は「mkbd.pretty/meishi.kicad_mod」として保存しています。

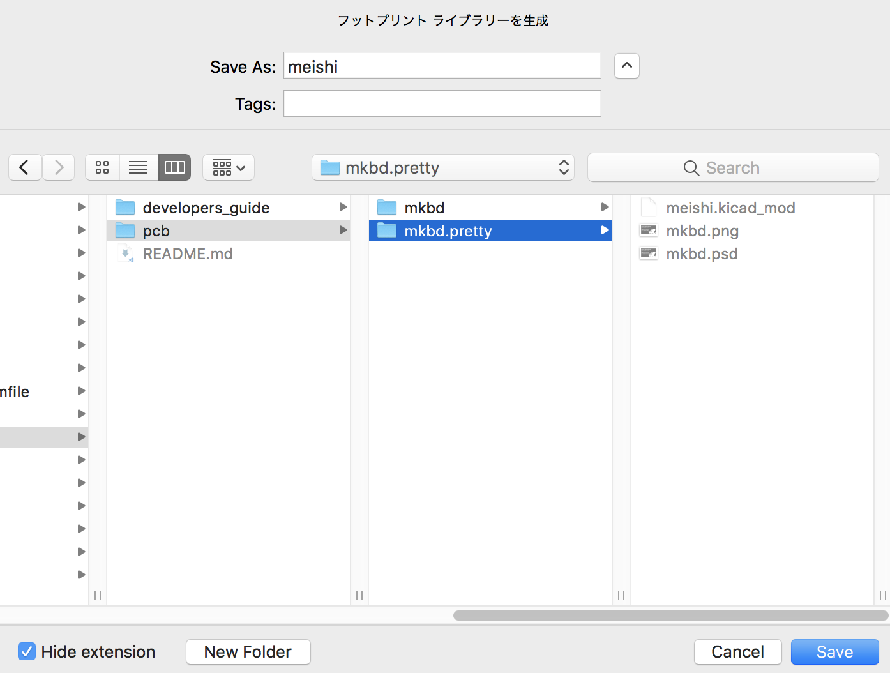
[picture p55: developers_guide/images/pcbnew/export.png]
export


Pcbnewの画面に戻り、「設定 > フットプリント ライブラリーを管理」を選択します。
[ライブラリーを参照] から先程作成した「mkbd.pretty」を選択します。

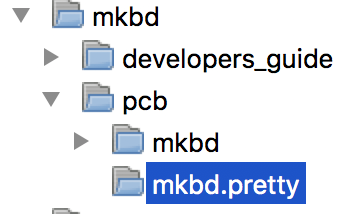
[picture p56: developers_guide/images/pcbnew/load_lib.png]
load_lib


これで作成した画像がシルクとして使えるようになりました。
「配置 > フットプリント」から配置してみます。
下記のように選択できるようになっているはずです。

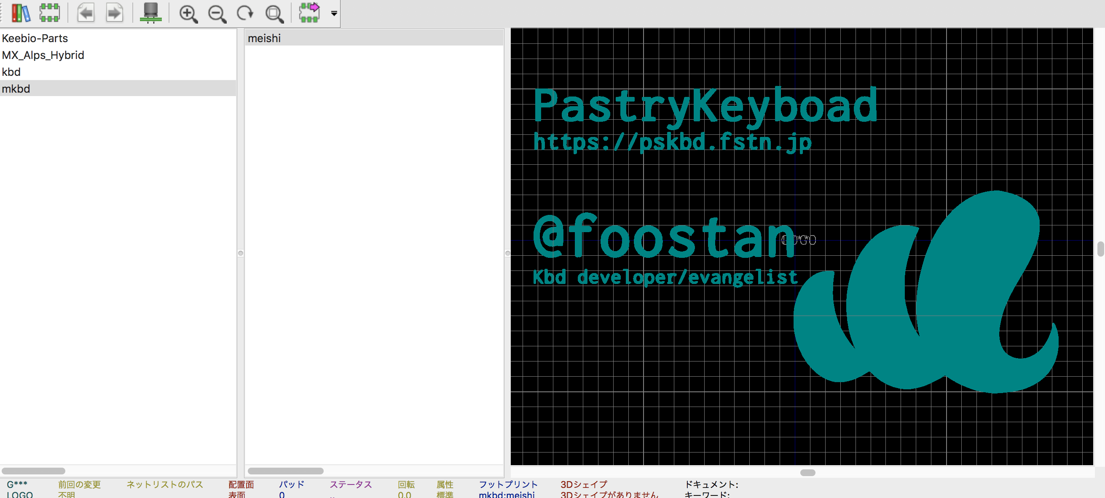
[picture p57: developers_guide/images/pcbnew/set_meishi_footprint.png]
set_meishi_footprint


あとは好みに配置して完成です。
今回は部品を実装しない裏側に設定しました。
なおフットプリントを裏返す場合は、フットプリントにカーソルを合わせてショートカット `e` から編集ウインドウを開き、
「基板側::表側」となっているのを「裏側」に変更します。

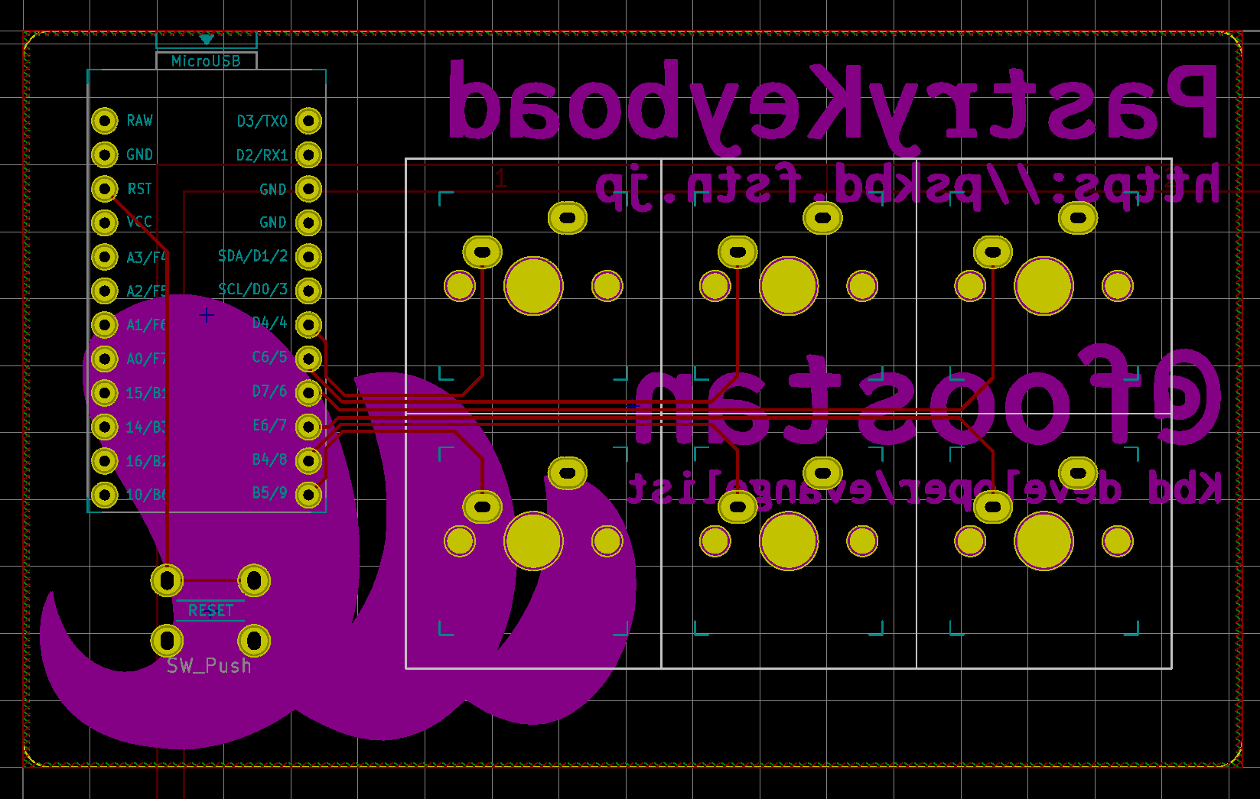
[picture p58: developers_guide/images/pcbnew/finished.png]
finished


以上で完成です。
最後にミスがないかチェックします。

上記メニューの「デザインルール チェックを実行」から

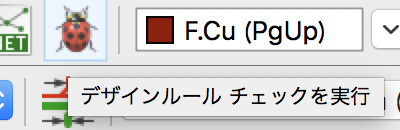
[picture p59: developers_guide/images/pcbnew/drc.png]
drc


[DRCの開始] を押してチェックします。問題や未配線がなければOKです。

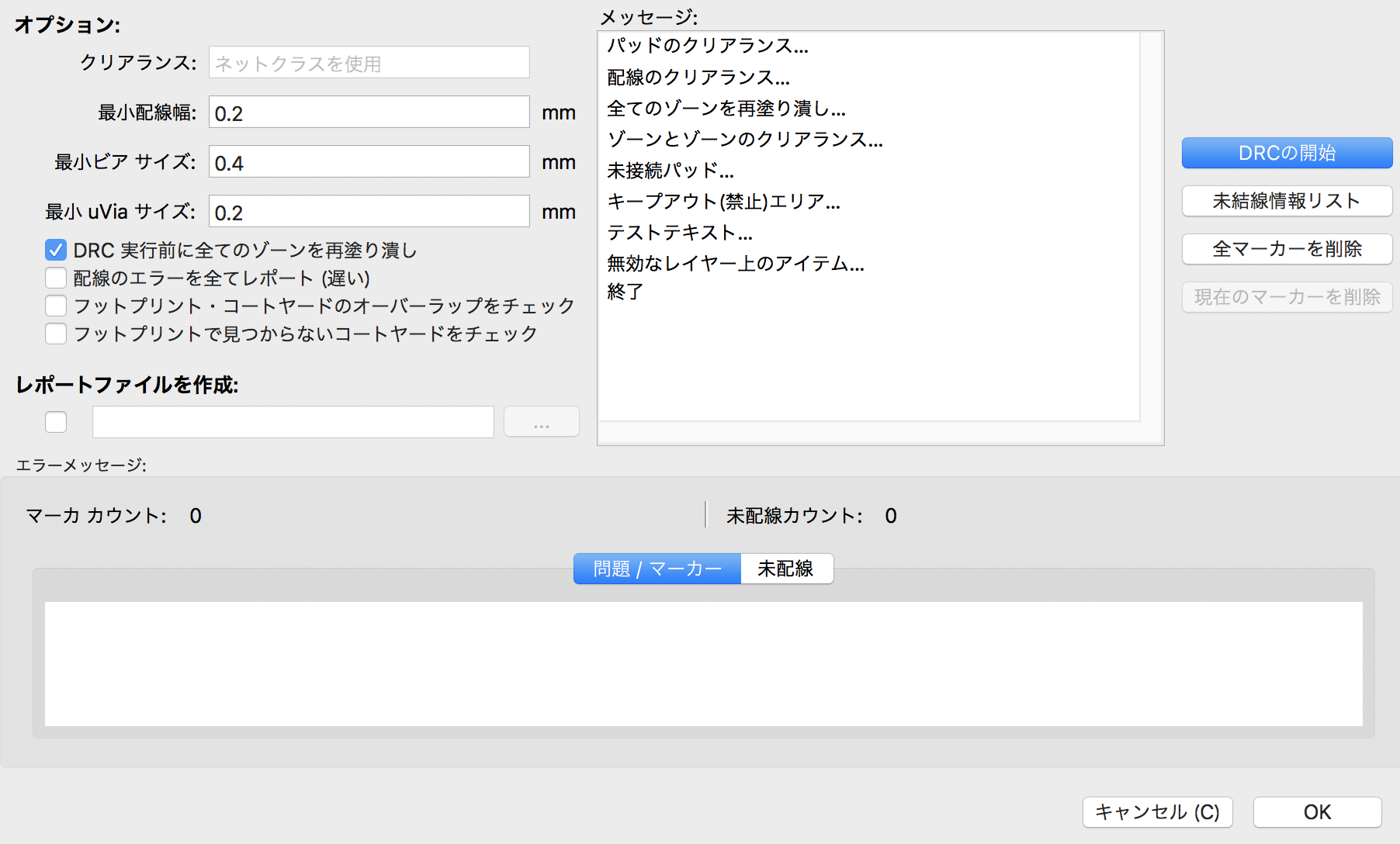
[picture p60: developers_guide/images/pcbnew/run_drc.png]
run_drc


完成したPCBを「表示 > 3Dビューアー」から確認してみます。

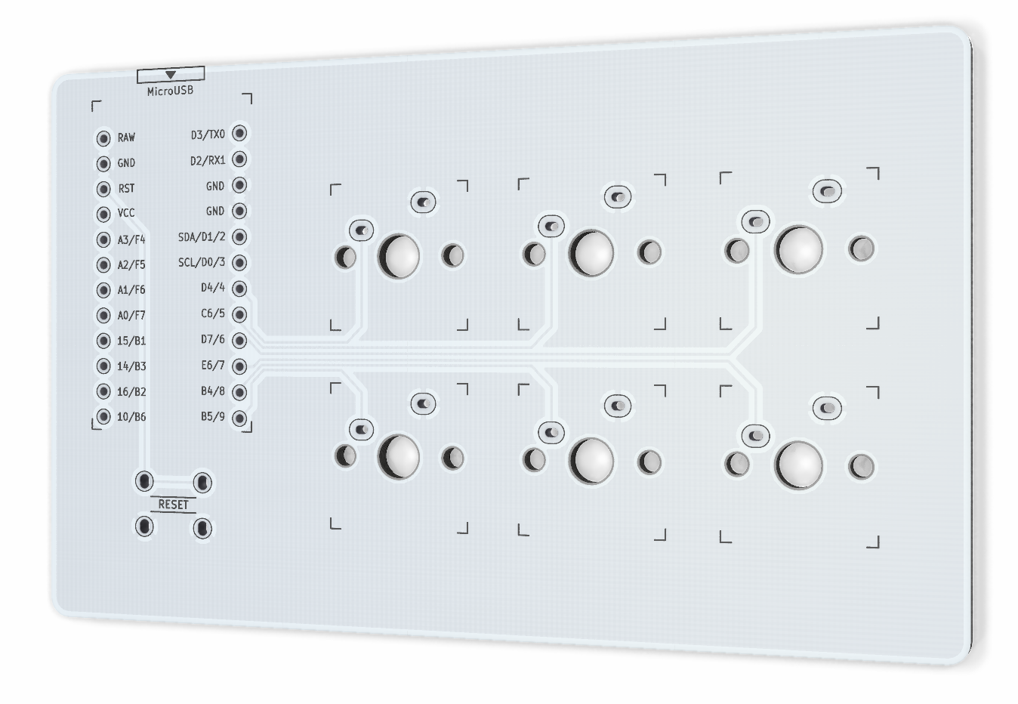
[picture p61: developers_guide/images/pcbnew/3d.png]
3d


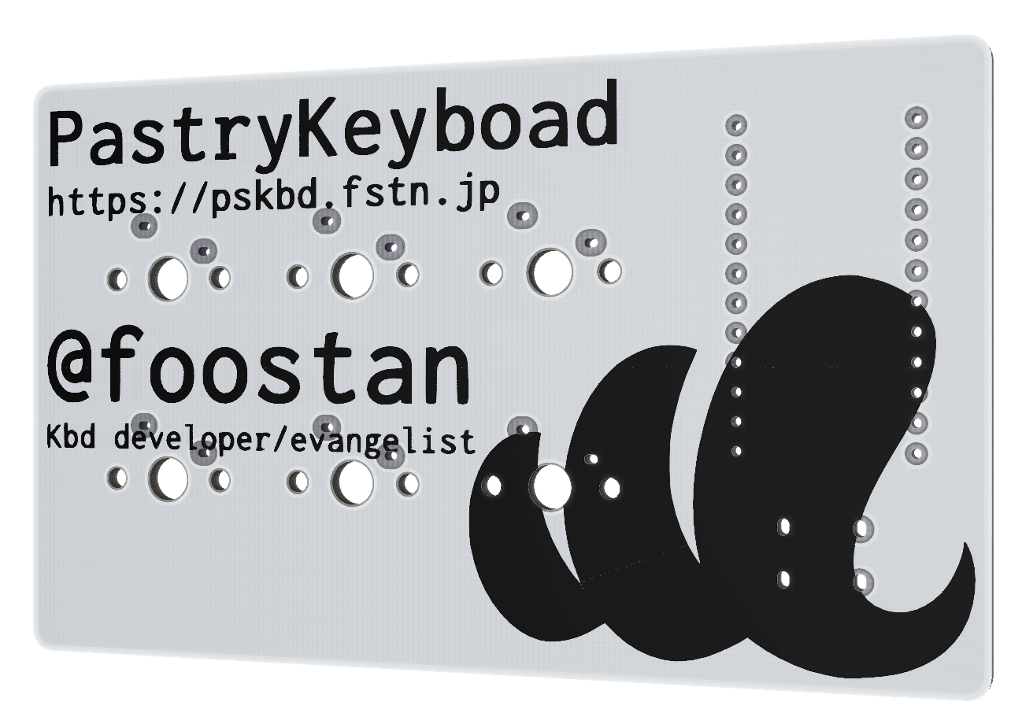
[picture p62: developers_guide/images/pcbnew/3d_back.png]
3d_back


### PCBの発注

完成したPCBのデータを業者へ発注する過程を説明します。

「ファイル > プロット」から製造用ファイルを生成します。

「含まれるレイヤー」にて、

- F.Cu
- B.Cu
- F.SilkS
- B.SilkS
- F.Mask
- B.Mask
- Edge.Cuts

を選択します。
あとはデフォルトのままです。
出力ディレクトリーをしていして [製造ファイル出力] をします。

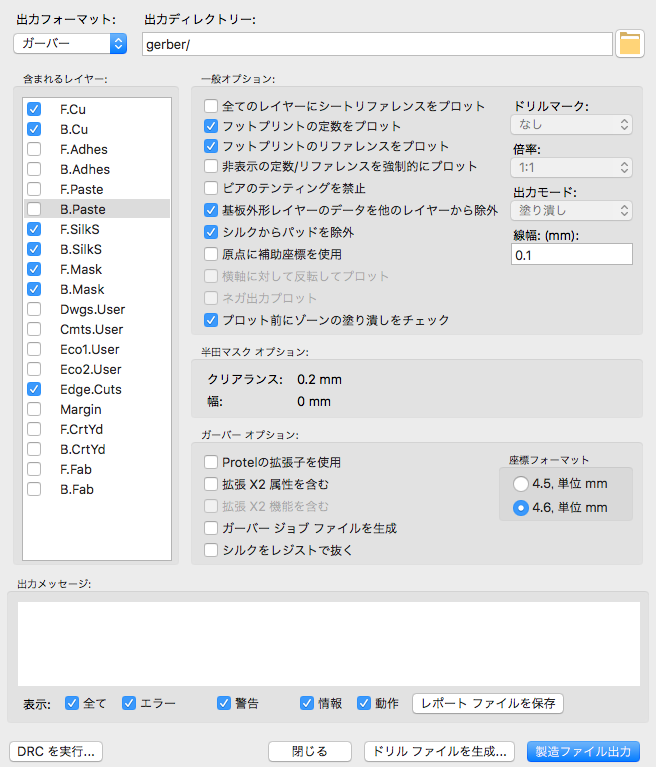
[picture p63: developers_guide/images/order/plot.png]
plot


また、ドリルデータも必要なので、[ドリル ファイルを生成...] から

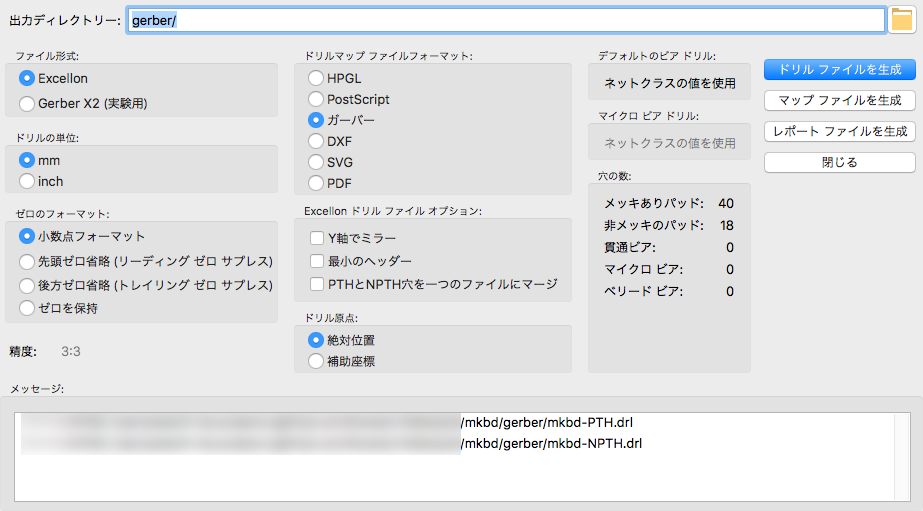
[picture p64: developers_guide/images/order/drill.png]
drill


[ドリル ファイルを生成] をします。
また生成した製造ファイル(ガーバーデータ)は zip 等で圧縮しておきます。

今回発注には Seeed の FusionPCB を利用します。
https://www.fusionpcb.jp/prototype-pcb-sale.html

こちらではオプションの制約はありますが、100mm x 100mm 以下のPCBの発注を $7.9 で行えるプランが有り、
またOCSを選択しても $12.90 と格安です(少し前までは更に安くて$10を切っていた)。

なお同じ構成で Elecrow に頼むと $18.13 でした。

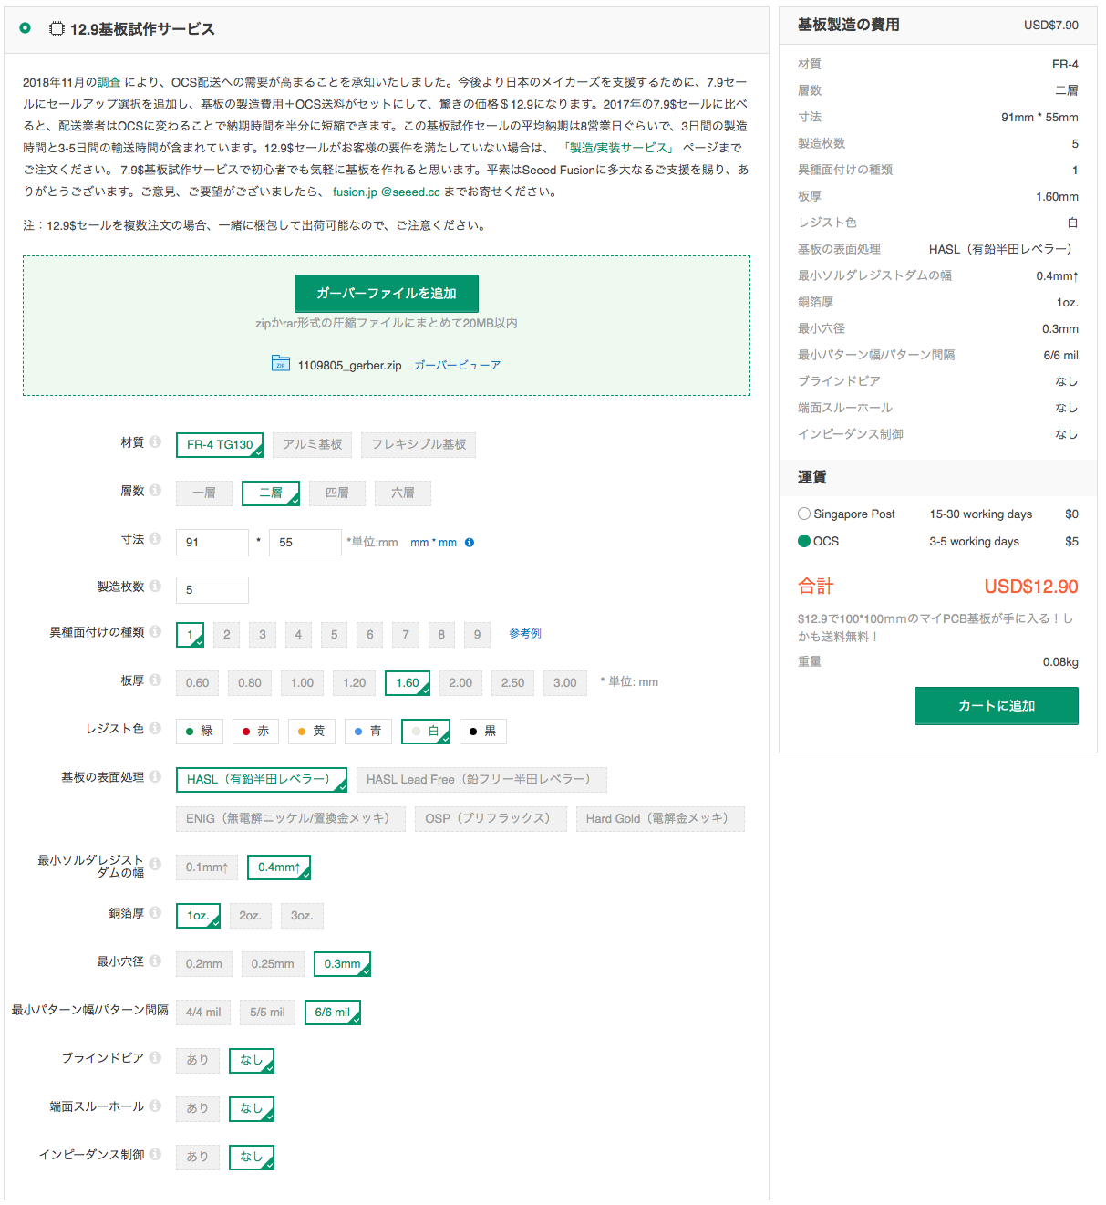
[picture p65: developers_guide/images/order/fusionpcb.png]
fusionpcb


あとは [カートに追加] し、注文すれば完了です。
