foostan/mkbd/pcb/mkbd/mkbd.kicad_pcb

## KiCad design pcb/mkbd/mkbd.kicad_pcb (2019-04-20)

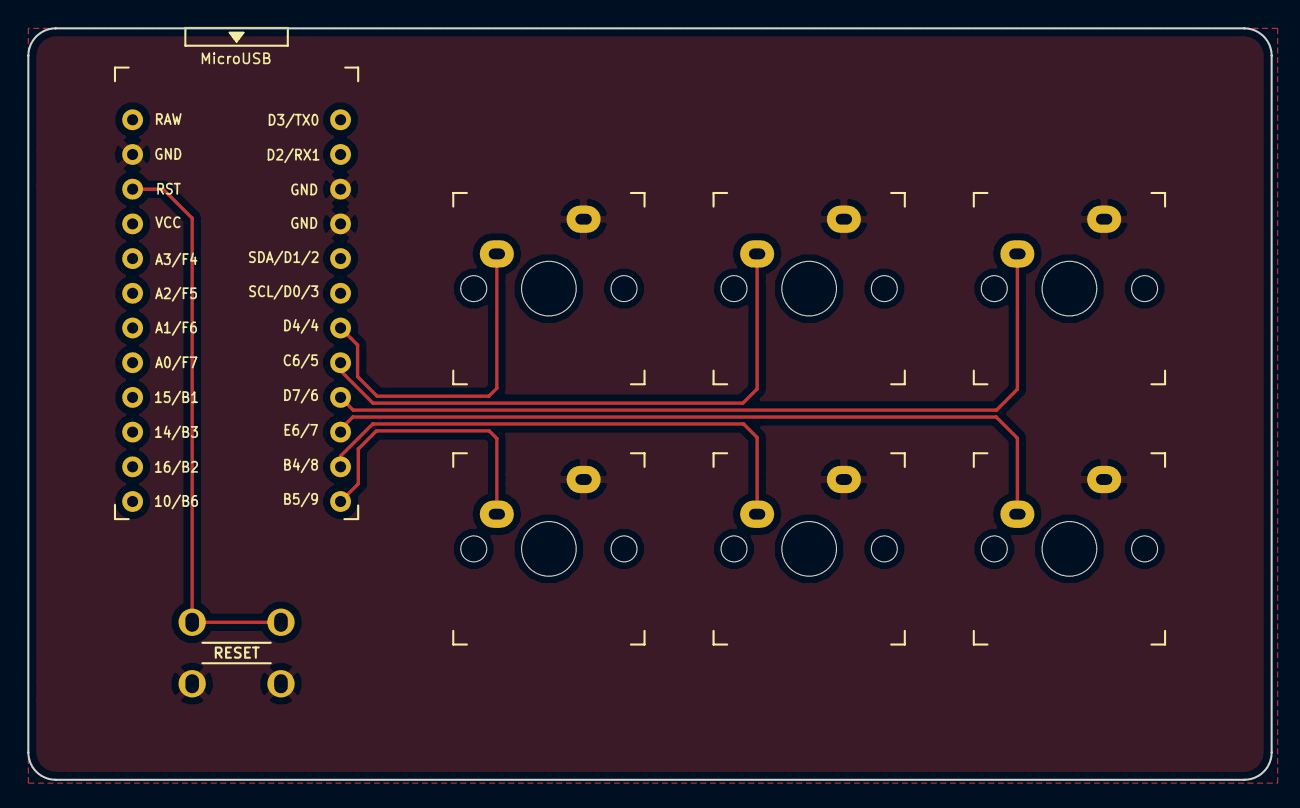
[picture p66: board mkbd.kicad_pcb from above]

Board: 2 copper layers, 91.0 x 55.0 mm, 8 parts (0 on the bottom side), 8 nets.

Parts:
RSW1: SW_Push; ResetSW_4
SW1, SW2, SW3, SW4, SW5, SW6: SW_PUSH; CherryMX_1u
U1: ProMicro_r; ProMicro_v3

Connections:
/RESET: RSW1.1, U1.22
/SW_1: SW1.1, U1.7
/SW_2: SW2.1, U1.8
/SW_3: SW3.1, U1.9
/SW_4: SW4.1, U1.10
/SW_5: SW5.1, U1.11
/SW_6: SW6.1, U1.12
GND: RSW1.2, SW1.2, SW2.2, SW3.2, SW4.2, SW5.2, SW6.2, U1.3, U1.4, U1.23
