foostan/mkbd/(commit log)

2019-04-20 Add meishi pcb
    [mkbd.kicad_pcb, mkbd.sch]
2020-06-02 Fix clashed
    [mkbd.kicad_pcb]
